andref796/AICE/AICE/bloques.jpg

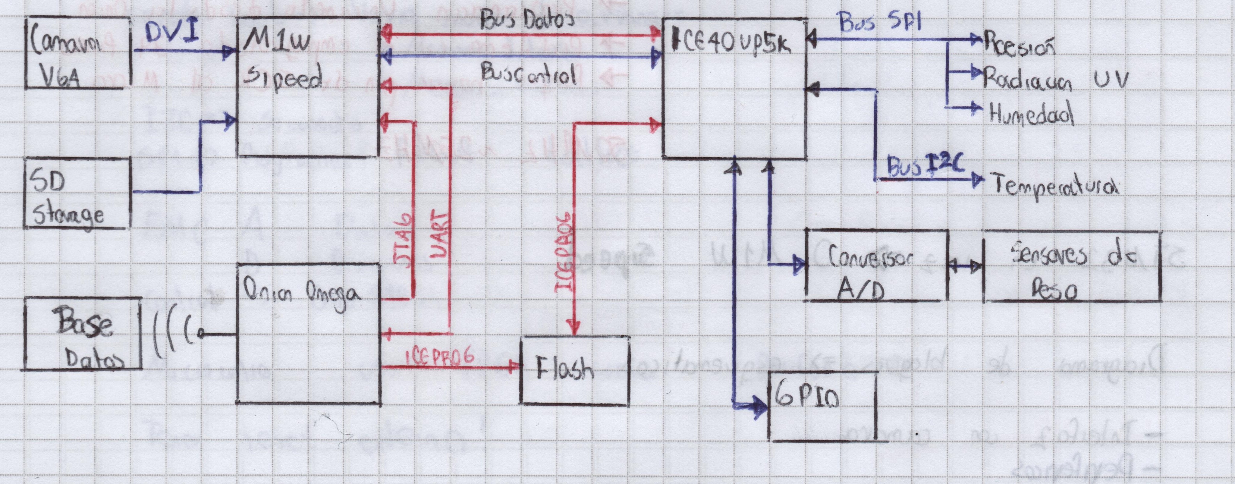
AICE/bloques.jpg
