andref796/AICE/AICE/AICE.xlsx

Customer Reference | Package | Quantity | Reference Designator | Digi-Key Part Number
C15,C14,C5 | C_0603_1608Metric | 3 | 10u | CL10A106MQ8NNNC
C22 | CP_Radial_D5.0mm_P2.00mm | 1 | 33u | 493-5346-1-ND
C33,C61,C60,C59,C56,C55,C52,C51,C48,C47,C44,C43,C39,C37,C36,C32,C31,C30,C29,C28,C27,C24,C23,C21,C20,C19,C18,C17,C16,C13,C12,C11,C10,C8,C7,C2,C26 | C_0603_1608Metric | 37 | 0.1u | 478-06036C104JAT2ACT-ND
C38 | C_1206_3216Metric | 1 | 220u | 490-13970-1-ND
C42 | C_0603_1608Metric | 1 | 0.001u | C0603C102K9RAC7867
C58,C57,C54,C53,C50,C49,C46,C45,C41,C40,C35,C34 | C_0805_2012Metric | 12 | 33u | 445-5986-1-ND
C6,C1 | C_0603_1608Metric | 2 | 1u | 311-1447-1-ND
C9,C4,C3 | C_0603_1608Metric | 3 | 0.01u | 399-8988-1-ND
D1 | LED_0603_1608Metric | 1 | CDBU0520 | 641-1332-1-ND
D10 | LED_0603_1608Metric | 1 | YLL | 720-KYDELMS122A1787
D2, D8 | LED_0603_1608Metric | 2 | GREEN | 720-KGDELMS122A4854
D3,D6 | LED_RGB_Cree-PLCC-6_6x5mm_P2.1mm | 2 | LED_RGB | CLP6C-FKB-CK1P1G1BB7R3R3CT-ND
D4 | D_SMA | 1 | SMAZ5V1-TP | SMAZ5V1-TPMSCT-ND
D5 | SOT-23 | 1 | SP0502BAHT | F2714CT-ND
D7 | LED_0603_1608Metric | 1 | RED | 720-KODELMS122A4855
H1,H2,H3,H4 | MountingHole_2.5mm_Pad | 4 | MountingHole_Pad
J1,J2,J5,J6 | PinHeader_2x50_P2.54mm_Vertical | 1 | Conn_02x50_Odd_Even | 649-77313-118-50LF
J3 | PinHeader_1x03_P2.54mm_Vertical | 1 | Conn_01x03
J4 | USB_A_Stewart_SS-52100-001x_Horizontal | 1 | USB_A | 380-1412-ND
J7 | microSD_HC_Wuerth_693072010801 | 1 | Micro_SD_Card | 732-3820-1-ND
J8 | USB_Micro-B_Molex_47346-0001 | 1 | USB_B_Micro | WM17141TR-ND
L8,L7,L6,L5,L4,L3,L2,L1 | L_0805_2012Metric | 8 | 2A 120 ohm | MH2029-121YCT-ND
Q1 | SOT-23 | 1 | S8550 | MMSS8550-H-TPMSCT-ND
R1,R50,R49,R48,R47,R46,R6,R5 | R_0603_1608Metric | 8 | 100R | 2019-RK73H1JTTD1000FCT-ND
R92,R91,R16,R15 | R_0603_1608Metric | 4 | 2K2 | 311-2.20KCRCT-ND
R102,R103,R104,R105 | R_0603_1608Metric | 4 | 4R7 | 2019-RK73H1JTTD4R70FCT-ND
R2,R95,R96,R98,R89,R37 | R_0603_1608Metric | 6 | 51R | 2019-RK73H1JTTD51R0FCT-ND
R90,R53,R4,R3,R94,R93,R54,R36,R27,R26,R25 | R_0603_1608Metric | 12 | 10K | 311-10KGRCT-ND
U1 | QFN-48-1EP_7x7mm_P0.5mm_EP5.6x5.6mm | 1 | ICE40UP5K-SG48ITR | 220-2212-1-ND
U11 | Molex_502231-2400_1x24-1SH_P0.5mm_Vertical | 1 | DVP_PORT | WM9863CT-ND
U13,U15 | SOT-223 | 2 | ZLDO1117G33TA | ZLDO1117G33DICT-ND
U14 | SOT-23 | 1 | XC6206P122MR | 865-XC6206P122MR-G
U16 | SOT-223 | 1 | ZLDO1117G18TA | ZLDO1117G18DICT-ND
U17 | SOT-23 | 1 | XC6206P282MR | 865-XC6206P282MR-G
U18 | SOT-23 | 1 | XC6206P152MR | 865-XC6206P152MR-G
U2 | ASFLMB | 1 | ASFLMB-24.00MHZ-LC-T | 535-11768-1-ND
U3,U7,U12 | SMS_BUTTON | 3 | SMS | 612-LL3303F065QG
U4 | SOIC-8_5.23x5.23mm_P1.27mm | 1 | W25Q | W25Q128JVSIQCT-ND
U5 | SOP-16_4.4x10.4mm_P1.27mm | 1 | HX711
U6 | Onion_Omega2+ | 1 | Omega2+
U8 | SRF2012 | 1 | SRF2012 | SRF2012-900YACT-ND
U9 | QFN-72_25.4x25.4_Pitch1.27mm | 1 | M1&M1W | 1597-1715-ND
