andref796/AICE/AICE/Presupuesto.xlsx

 |  |  |  |  |  | Connector Header Through Hole 50 position 0.100" (2.54mm)
Componente | Referencia | Empaquetado | Precio | Cantidad | Total | Link
Regulador 2,8 V | XC6206P282MR-G | SOT-23-3 | 0.67 | 1 | 0.67 | https://co.mouser.com/ProductDetail/Torex-Semiconductor/XC6206P282MR-G
Regulador 1,5 V | XC6206P152MR-G | SOT-23-3 | 0.67 | 1 | 0.67 | https://co.mouser.com/ProductDetail/Torex-Semiconductor/XC6206P152MR-G
Regulador 3,3 V | ZLDO1117G33TA | SOT-223-3 | 0.47 | 2 | 0.94 | https://co.mouser.com/ProductDetail/Diodes-Incorporated/ZLDO1117G33TA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
Micro USB B Connector | 0473460001 Molex | N/A | 0.5 | 1 | 0.5 | https://www.digikey.com/product-detail/es/molex/0473460001/WM17141TR-ND/1782470
Micro SD Card | 693072010801 | N/A | 3.2 | 1 | 3.2 | https://www.digikey.com/product-detail/es/w%C3%BCrth-elektronik/693072010801/732-3820-2-ND/3124584
Flash | W25Q128JVSIQ TR | SOIC-8 | 1.54 | 1 | 1.54 | https://www.digikey.com/product-detail/en/winbond-electronics/W25Q128JVSIQ-TR/W25Q128JVSIQCT-ND/7087212
Connector Header Through Hole 50 position 0.100" (2.54mm) | N/A | N/A | 2.15 | 1 | 2.15 | https://co.mouser.com/ProductDetail/Amphenol-FCI/77313-118-50LF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
RBG_LED | CREE_PLCC6 | N/A | 0.57 | 2 | 1.14 | https://www.digikey.com/product-detail/es/cree-inc/CLP6C-FKB-CK1P1G1BB7R3R3/CLP6C-FKB-CK1P1G1BB7R3R3CT-ND/6138635
R 2,2k | RC0805FR-072K2L | 805 | 0.1 | 8 | 0.8 | https://www.digikey.com/product-detail/es/yageo/RC0805FR-072K2L/311-2-20KCRCT-ND/730623
R 10 k | RC0603JR-0710KL | 603 | 0.1 | 12 | 1.2 | https://www.digikey.com/product-detail/es/yageo/RC0603JR-0710KL/311-10KGRCT-ND/729647
R 100 |  | 603 | 0.57 |  |  | https://co.mouser.com/ProductDetail/Susumu/RGT1608P-101-B-T5
C 0,1 u FILM | ECP-U1C104MA5 | 805 | 0.66 | 37 |  | https://www.digikey.com/product-detail/en/panasonic-electronic-components/ECP-U1C104MA5/PCF1126CT-ND/285453
C 0,01 u CERAMIC | C0603C103KARACAUTO | 603 | 0.12 | 3 |  | https://co.mouser.com/ProductDetail/TDK/CGA1A2X7R1A103K030BA
C 33 u CERAMIC |  | 805 | 0.87 | 13 |  | https://co.mouser.com/ProductDetail/TDK/C2012X5R0J336M125AC?qs=sGAEpiMZZMs0AnBnWHyRQFzBYxg9rzNcNpoiI6kZLEA%3D
C 220 u Ceramic |  | 1206 | 1.35 | 2 |  | https://co.mouser.com/ProductDetail/Murata-Electronics/GRM31CC80G227ME11K
C 1 u CERAMIC |  | 805 | 0.21 | 2 |  | https://co.mouser.com/ProductDetail/Taiyo-Yuden/UMF212B7105MGHT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
C 10 u CERAMIC |  | 805 | 0.22 | 3 |  | https://co.mouser.com/ProductDetail/Taiyo-Yuden/TMK212BBJ106MGHT
C 1 n CERAMIC |  | 603 | 0.28 | 1 |  | https://co.mouser.com/ProductDetail/TDK/C1608C0G2A102J080AE
LED BLUE |  | 603 | 0.49 |  |  | https://co.mouser.com/ProductDetail/OSRAM-Opto-Semiconductors/KB-DELPS212-QHRI-24-Z555-10-S
LED GREEN |  | 603 | 0.49 |  |  | https://co.mouser.com/ProductDetail/OSRAM-Opto-Semiconductors/KG-DELMS122-PHQI-24-E6L6
LED YELLOW |  | 603 | 0.39 |  |  | https://co.mouser.com/ProductDetail/OSRAM-Opto-Semiconductors/KY-DELLS122-KGLH-26
LED RED |  | 603 | 0.41 |  |  | https://co.mouser.com/ProductDetail/OSRAM-Opto-Semiconductors/KR-DELPS122-UHVI-26-H3Q4
CDBU0520 |  | 603 | 0.45 | 1 |  | https://co.mouser.com/ProductDetail/Comchip-Technology/CDBU0520
ASFLMB-24.000MHZ-LC-T |  |  | 1.51 |  |  | https://co.mouser.com/ProductDetail/ABRACON/ASFLMB-24000MHZ-LC-T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
FPC 2-84952-4 |  | N/A | 1.7 | 1 |  | https://www.digikey.com/product-detail/en/te-connectivity-amp-connectors/2-84952-4/A100254CT-ND/2180595
Button SMS |  |  | 0.6 | 4 |  | https://co.mouser.com/ProductDetail/E-Switch/LL3303F065QG?qs=sGAEpiMZZMvxtGF7dlGNpqqmTFthXBmf4pe9dF4lIR4%3D
SP0502BAHTG |  | SOT-23 | 0.66 | 1 |  | https://co.mouser.com/ProductDetail/Littelfuse/SP0502BAHTG
SRF2012-900YA |  | N/A | 0.41 | 1 |  | https://www.digikey.com/product-detail/es/bourns-inc/SRF2012-900YA/SRF2012-900YADKR-ND/2681279
S8550 |  | SOT-23 | 0.19 | 1 |  | https://co.mouser.com/ProductDetail/Micro-Commercial-Components-MCC/MMSS8550-H-TP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
FERRITA |  | 805 | 0.1 | 5 |  | https://co.mouser.com/ProductDetail/Bourns/MH2029-121Y?qs=aqFbwuCjQol7Vp3nXKKAXw%3D%3D
 |  |  |  |  |  | https://co.mouser.com/datasheet/2/348/sa5m-1143841.pdf
DVP Connector |  |  | 1.52 | 1 |  | https://www.digikey.com/product-detail/en/molex/5022442430/WM14450DKR-ND/6133348
