andref796/AICE/AICE/Omega2P v17.step

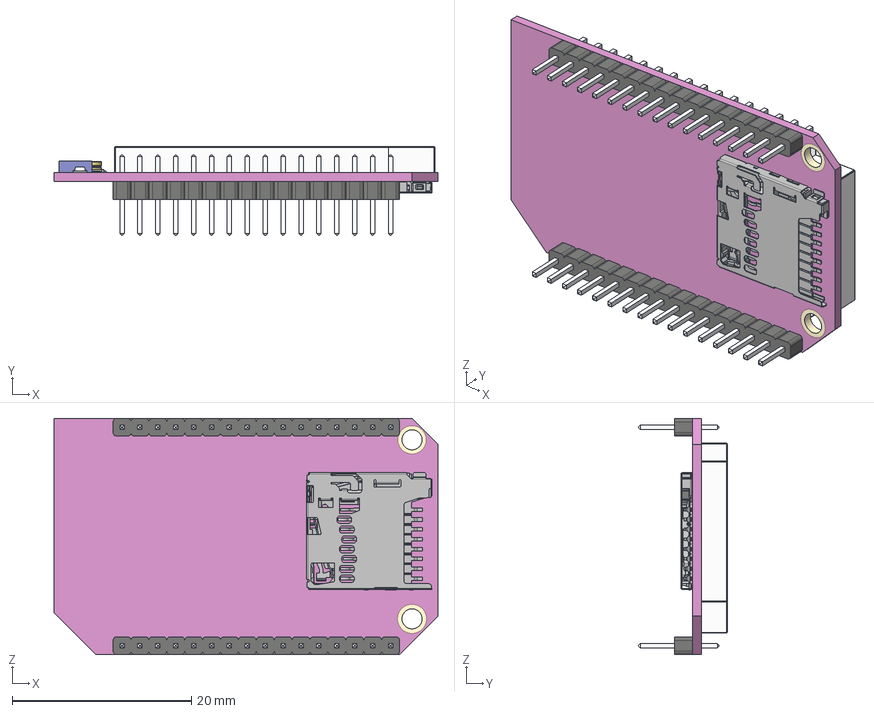
[picture p2: CAD file, 2020-06-23]
AICE/Omega2P v17.step
42.9 x 9.91 x 26.4 mm
5033981892 - MicroSD
Header SIP Male 2.00mm Pitch x 2
ufl
Chip Antenna
0603 LED
