andref796/AICE/(list of files, cad)

Other CAD files:
AICE/3D case/write/braille.dxf
AICE/3D case/write/Letters.dxf
AICE/3D case/write/knewave.dxf
AICE/3D case/write/BlackRose.dxf
AICE/3D case/write/orbitron.dxf
AICE/3D case/write/Write.scad
AICE/3D case/write/TestFont.scad
AICE/3D case/write/TestFont2.scad
AICE/3D case/write/TestSurfaceText.scad
AICE/3D case/write/TestWrite.scad
AICE/3D case/write/TestWriteCube.scad
AICE/3D case/write/TestWriteCylinder.scad
AICE/3D case/write/TestWriteSphere.scad
