andref796/AICE/Ejemplos/chip_media.pdf

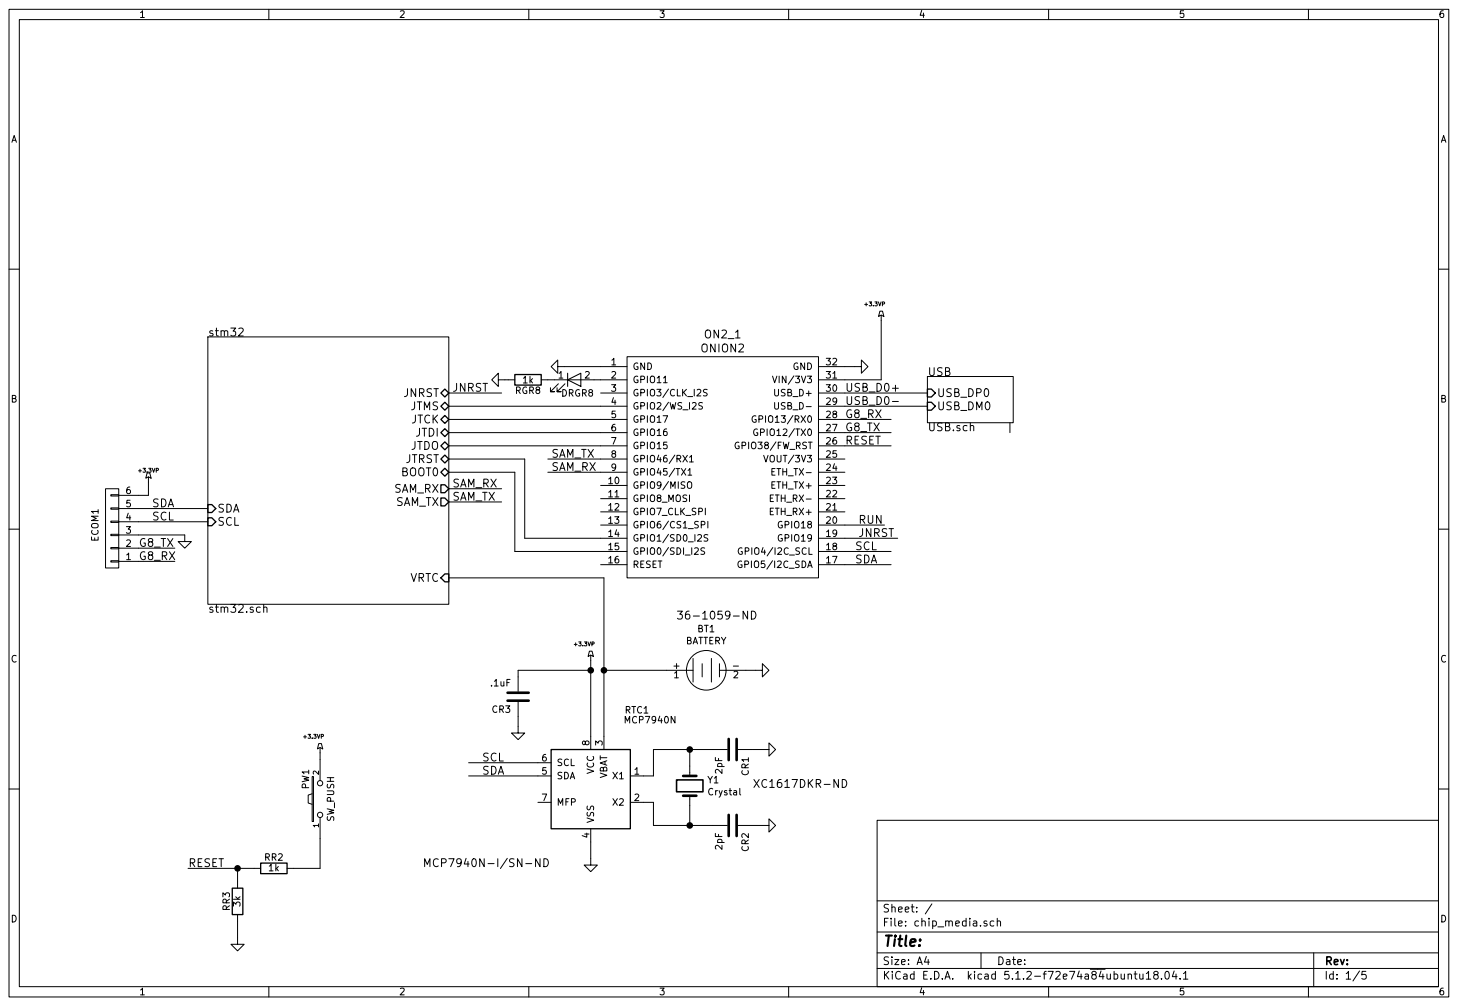
[picture p3: page 1]

4 SDA 5 SCL 6 MFP 7 VCC

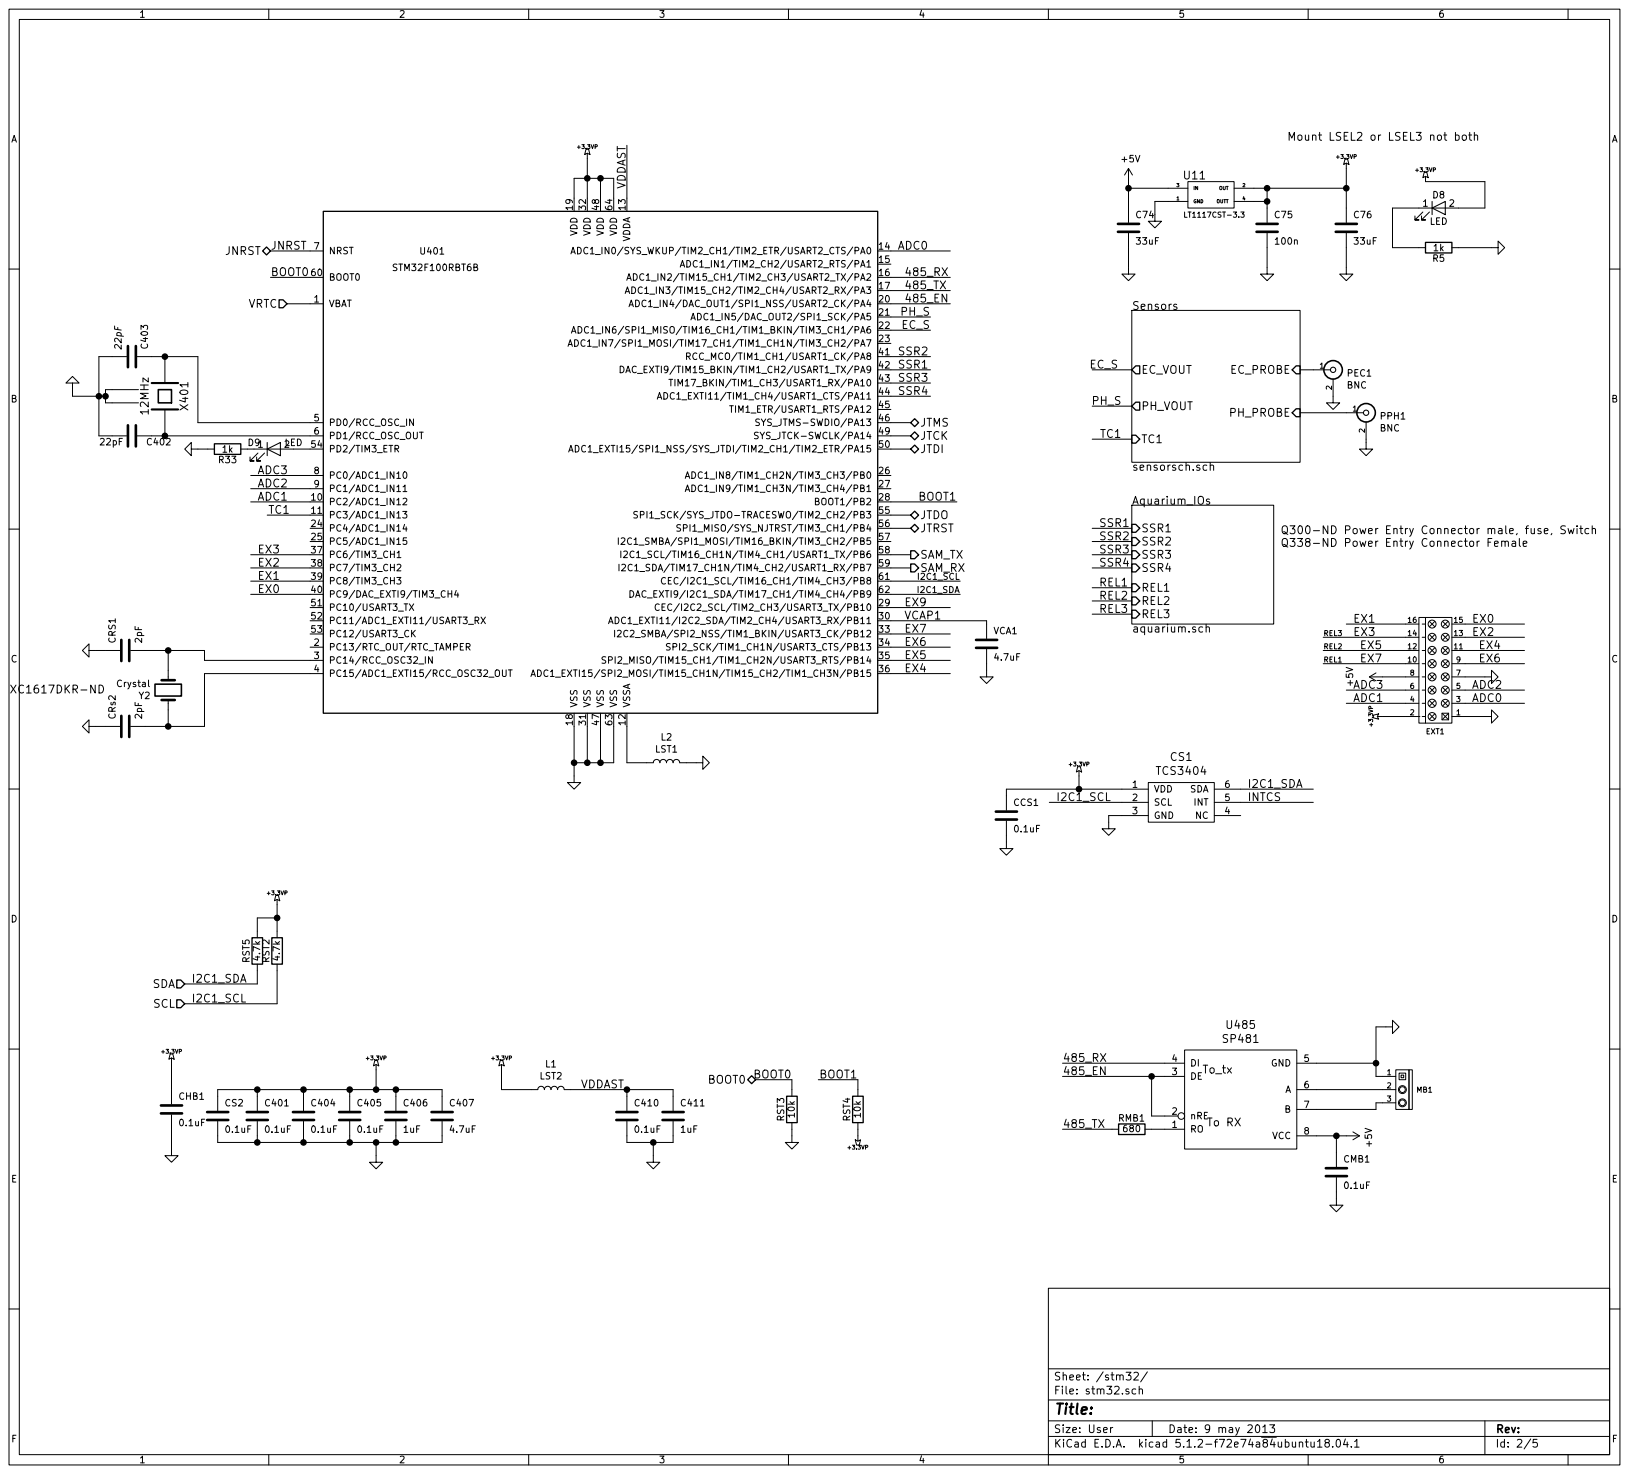
[picture p4: page 2]

Mount LSEL2 or LSEL3 not both

Q338-ND Power Entry Connector Female SSR3

Id: 2/5 Title: File: stm32.sch Sheet: /stm32/

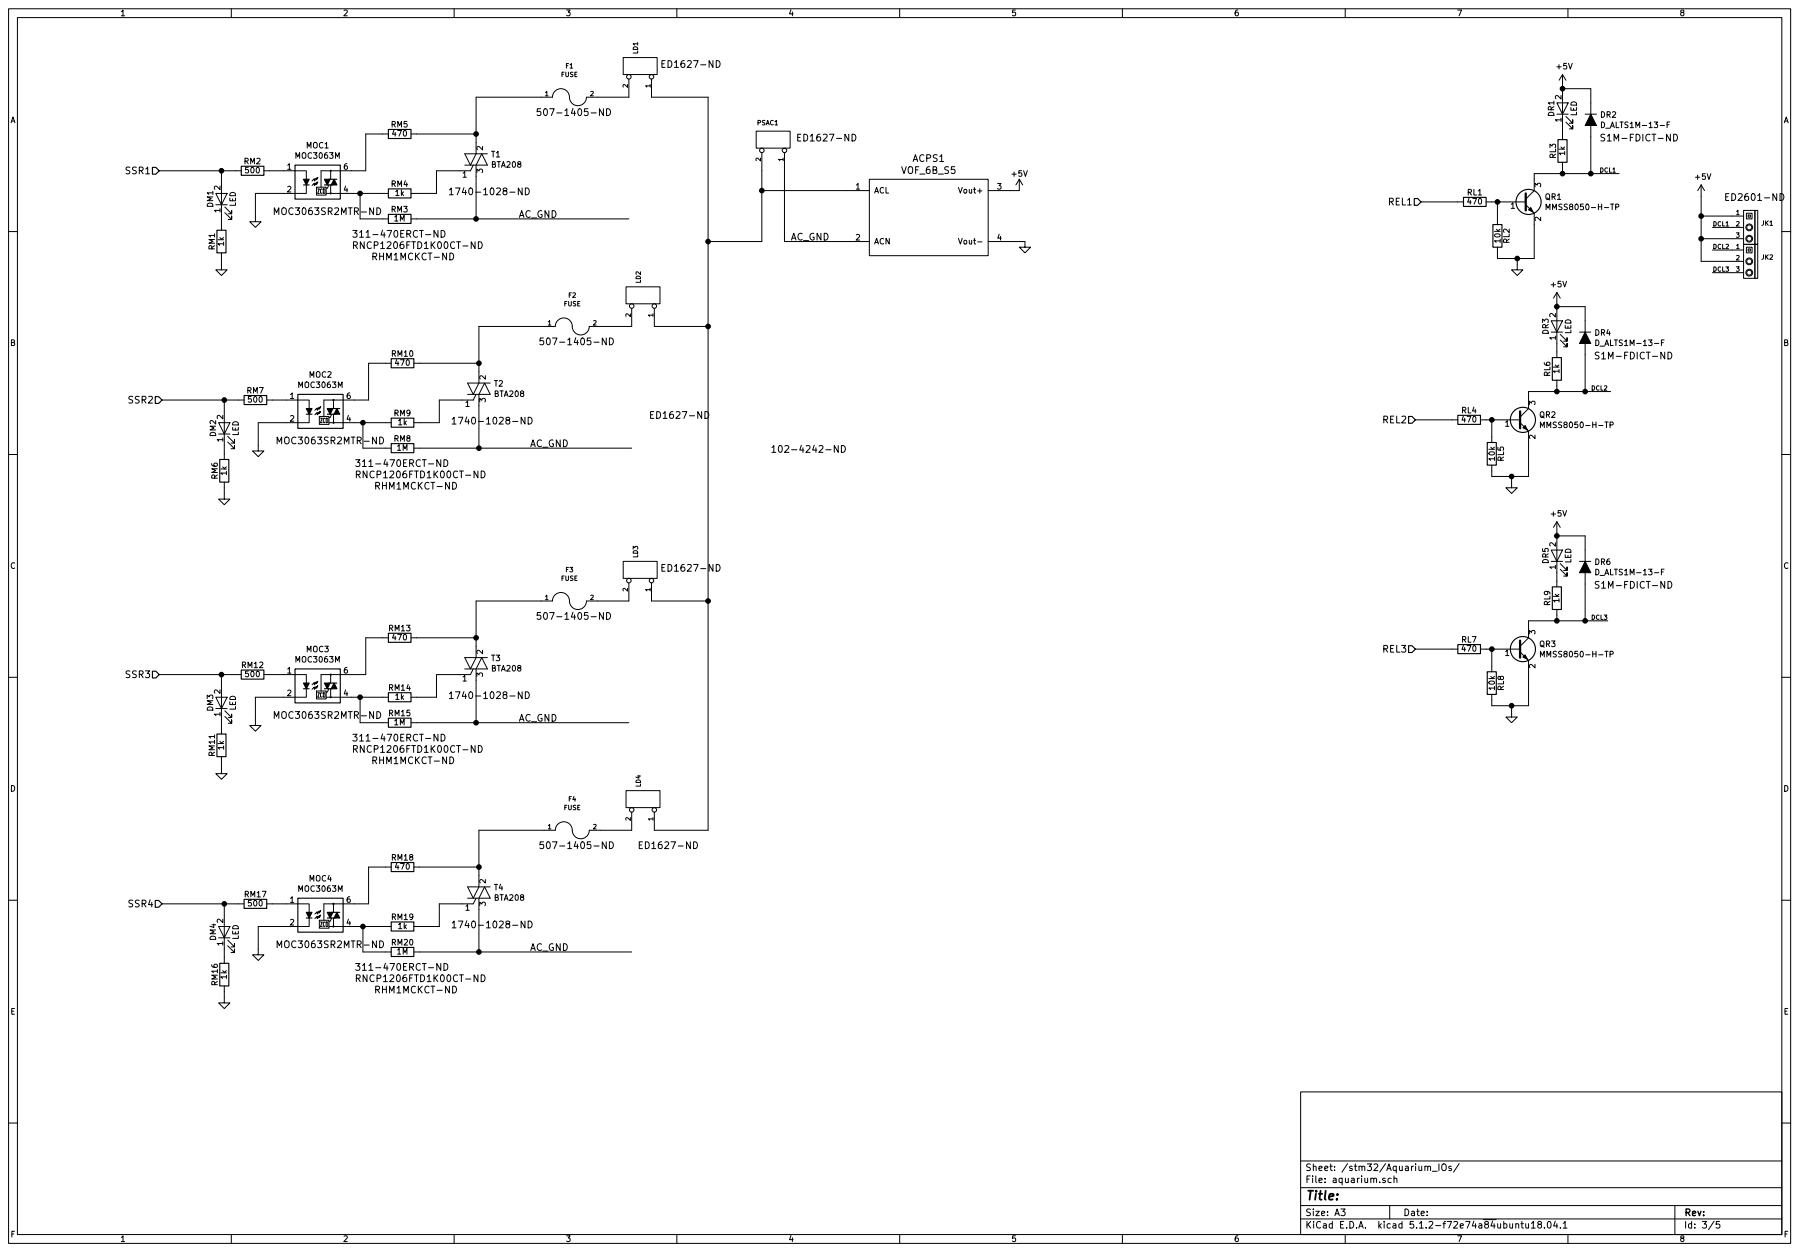
[picture p5: page 3]

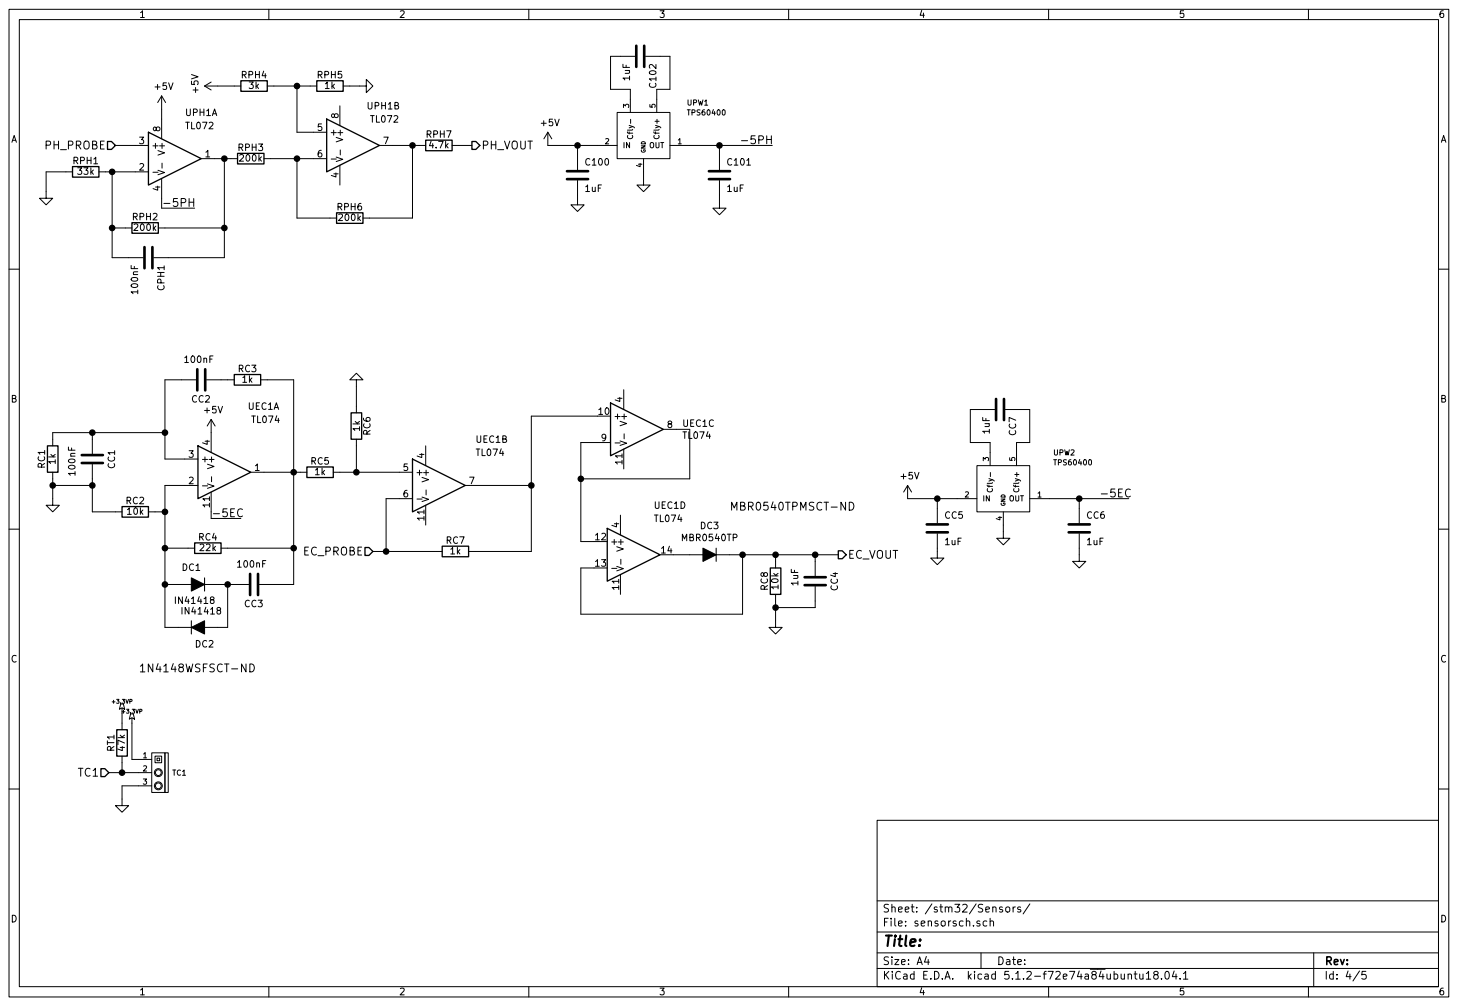
[picture p6: page 4]

Id: 4/5 Title: File: sensorsch.sch Sheet: /stm32/Sensors/ V- 4 V+

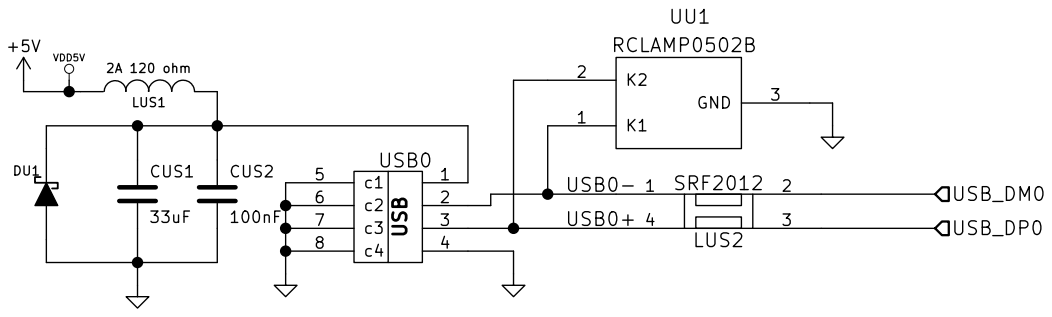
[picture p7: page 5]
