andref796/AICE/Ejemplos/i.MX283_Board.pdf

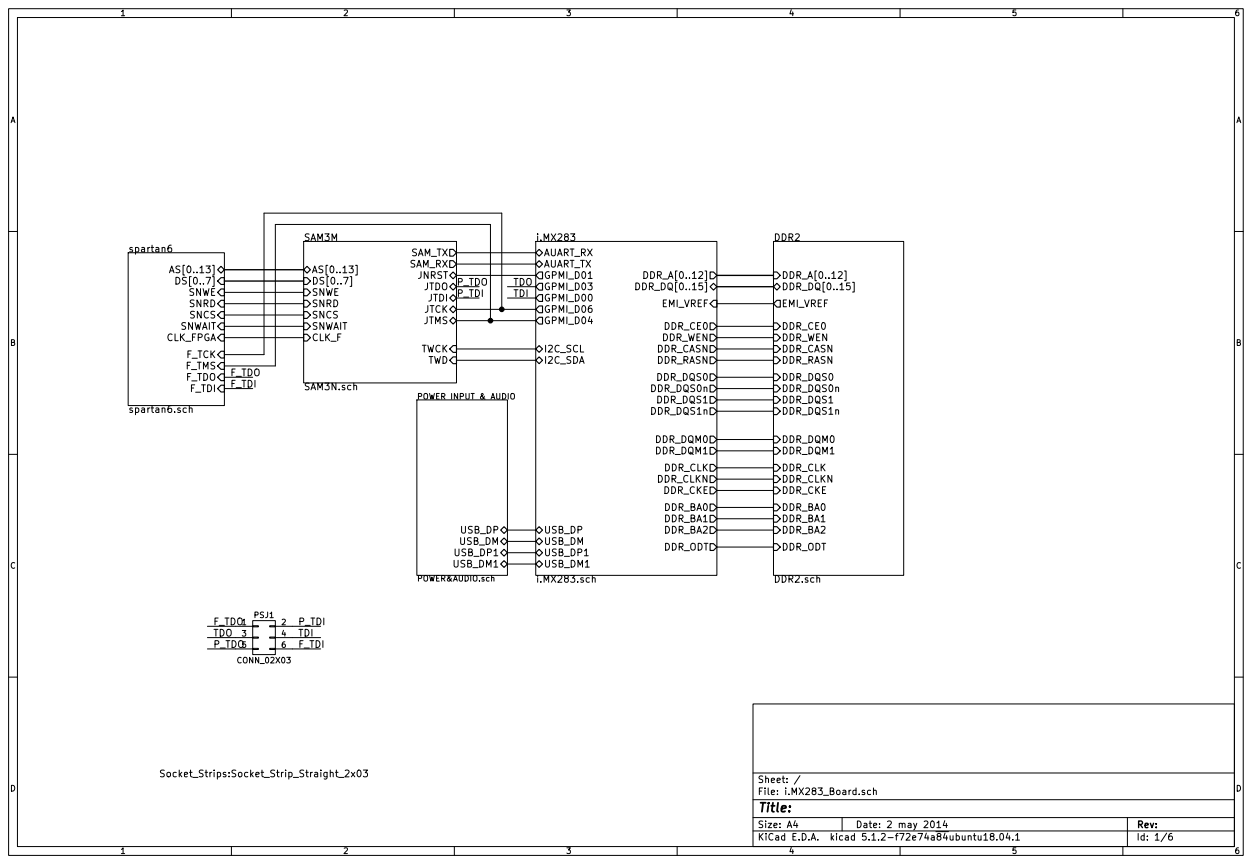
[picture p8: page 1]

SAM_TX SNRD JTCK SNCS JTMS SNWAIT TWCK TWD

P_TDO | TDO
P_TDI

F_TDI

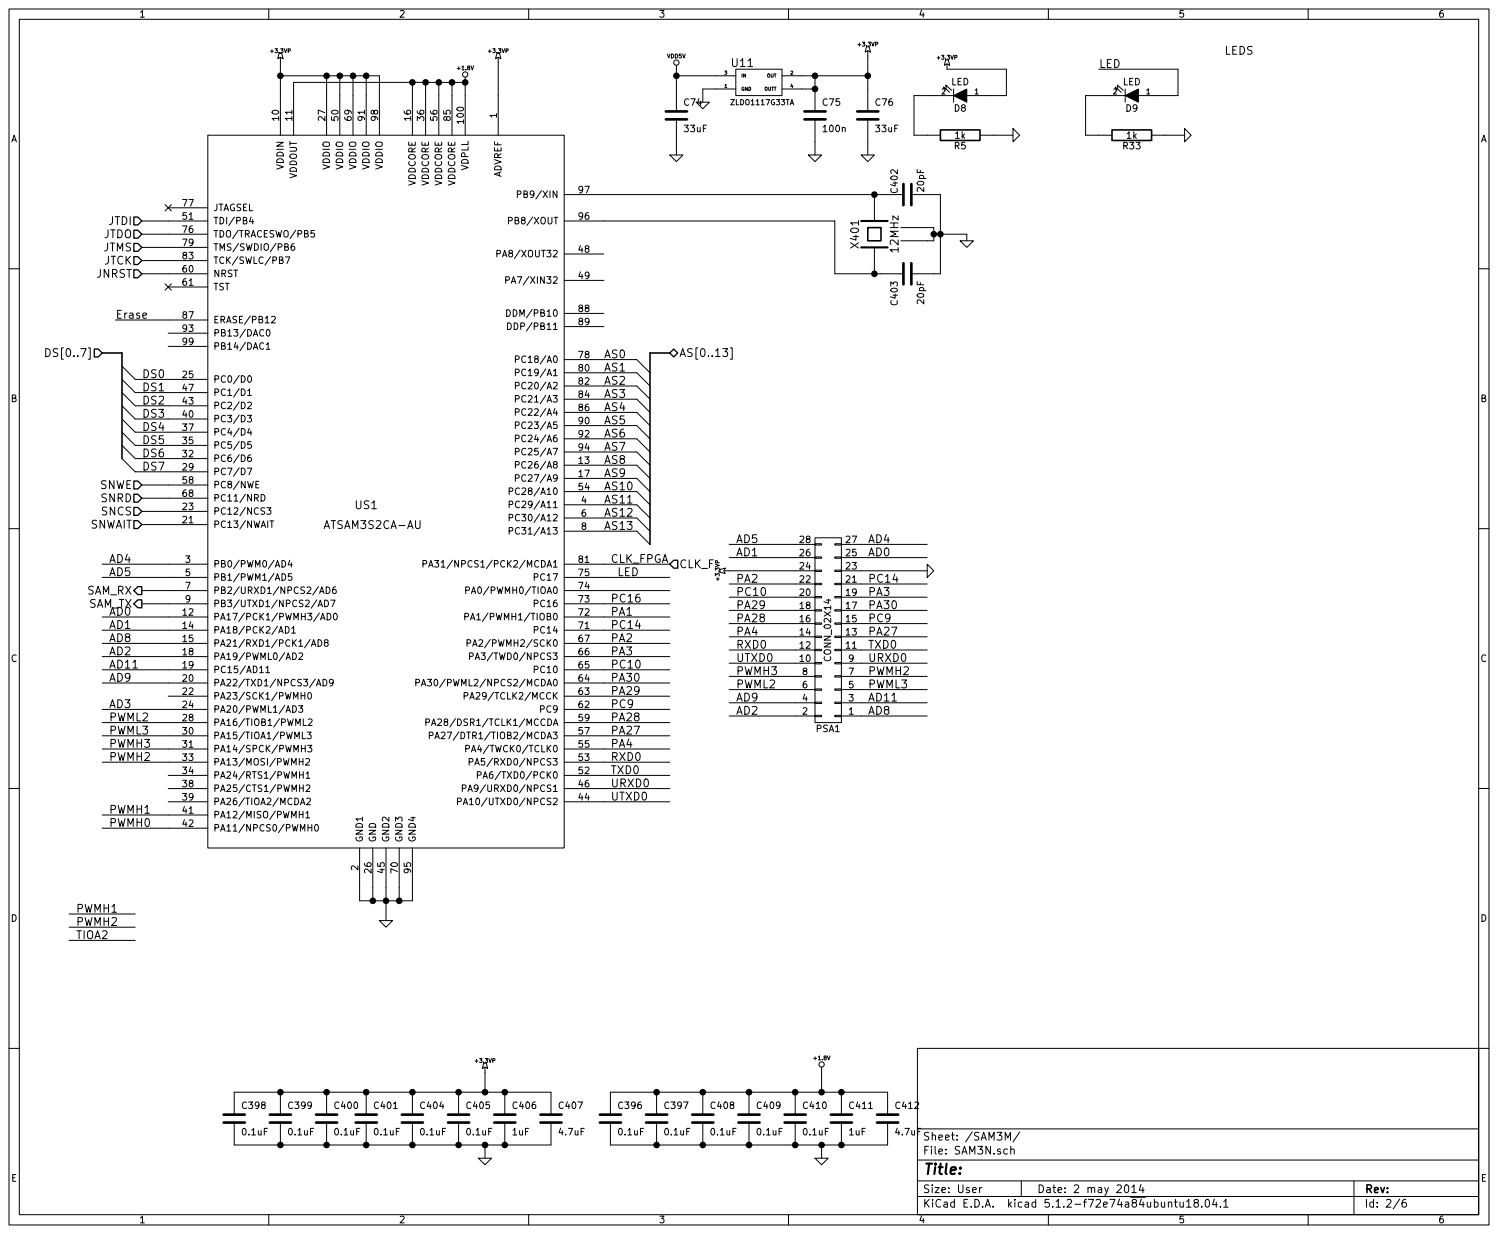
[picture p9: page 2]

2 PB0/PWM0/AD4 3 PC29/A11 4 PB1/PWM1/AD5 5 PC30/A12 6 PB2/URXD1/NPCS2/AD6 7 PC31/A13 8 PB3/UTXD1/NPCS2/AD7 9 VDDIN 10 PA22/TXD1/NPCS3/AD9 20 PA15/TIOA1/PWML3 30 PC3/D3 40 VDDIO 50 NRST 60 GND3 70 PC19/A1 80 PC23/A5 90 VDDOUT 11 PC13/NWAIT 21 PA14/SPCK/PWMH3 31 PA12/MISO/PWMH1 41

Id: 2/6 Title: File: SAM3N.sch Sheet: /SAM3M/

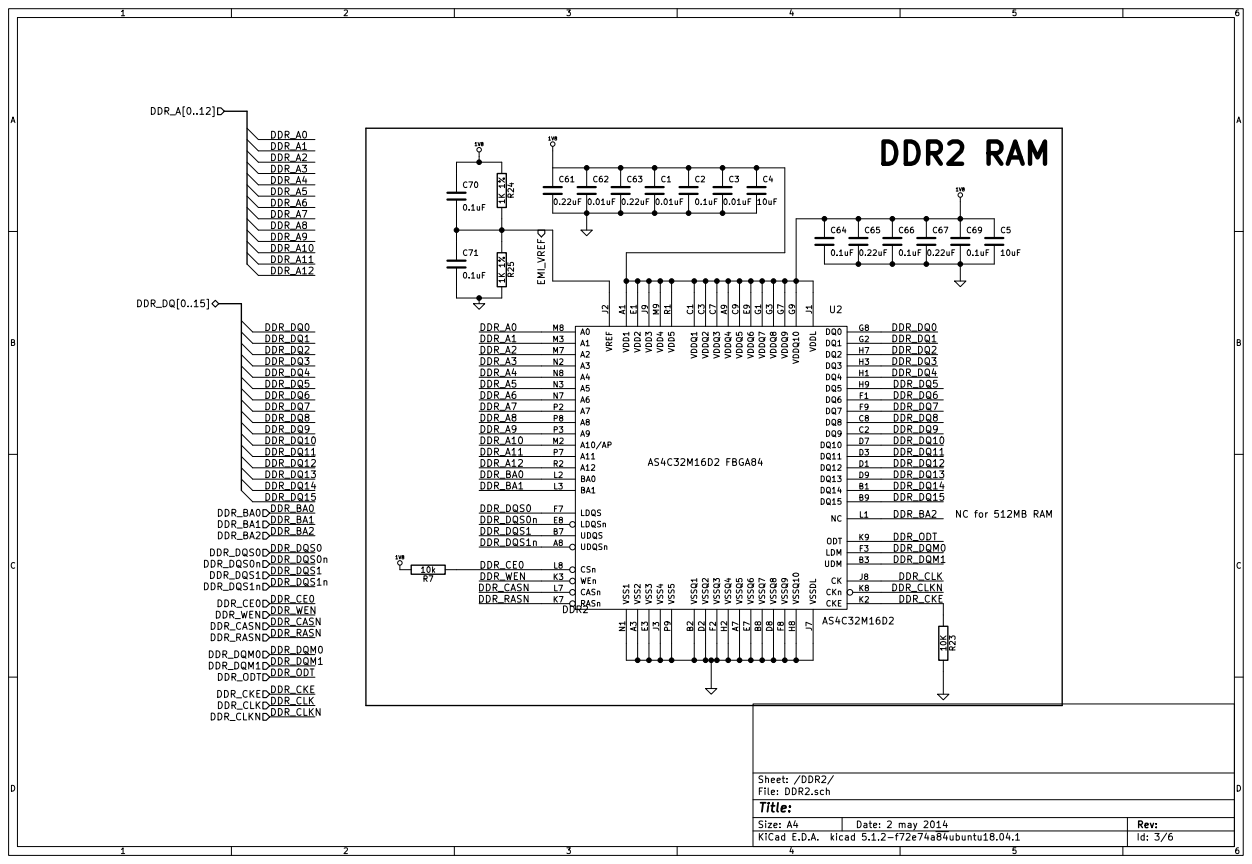
[picture p10: page 3]

Id: 3/6 Title: File: DDR2.sch Sheet: /DDR2/ R7

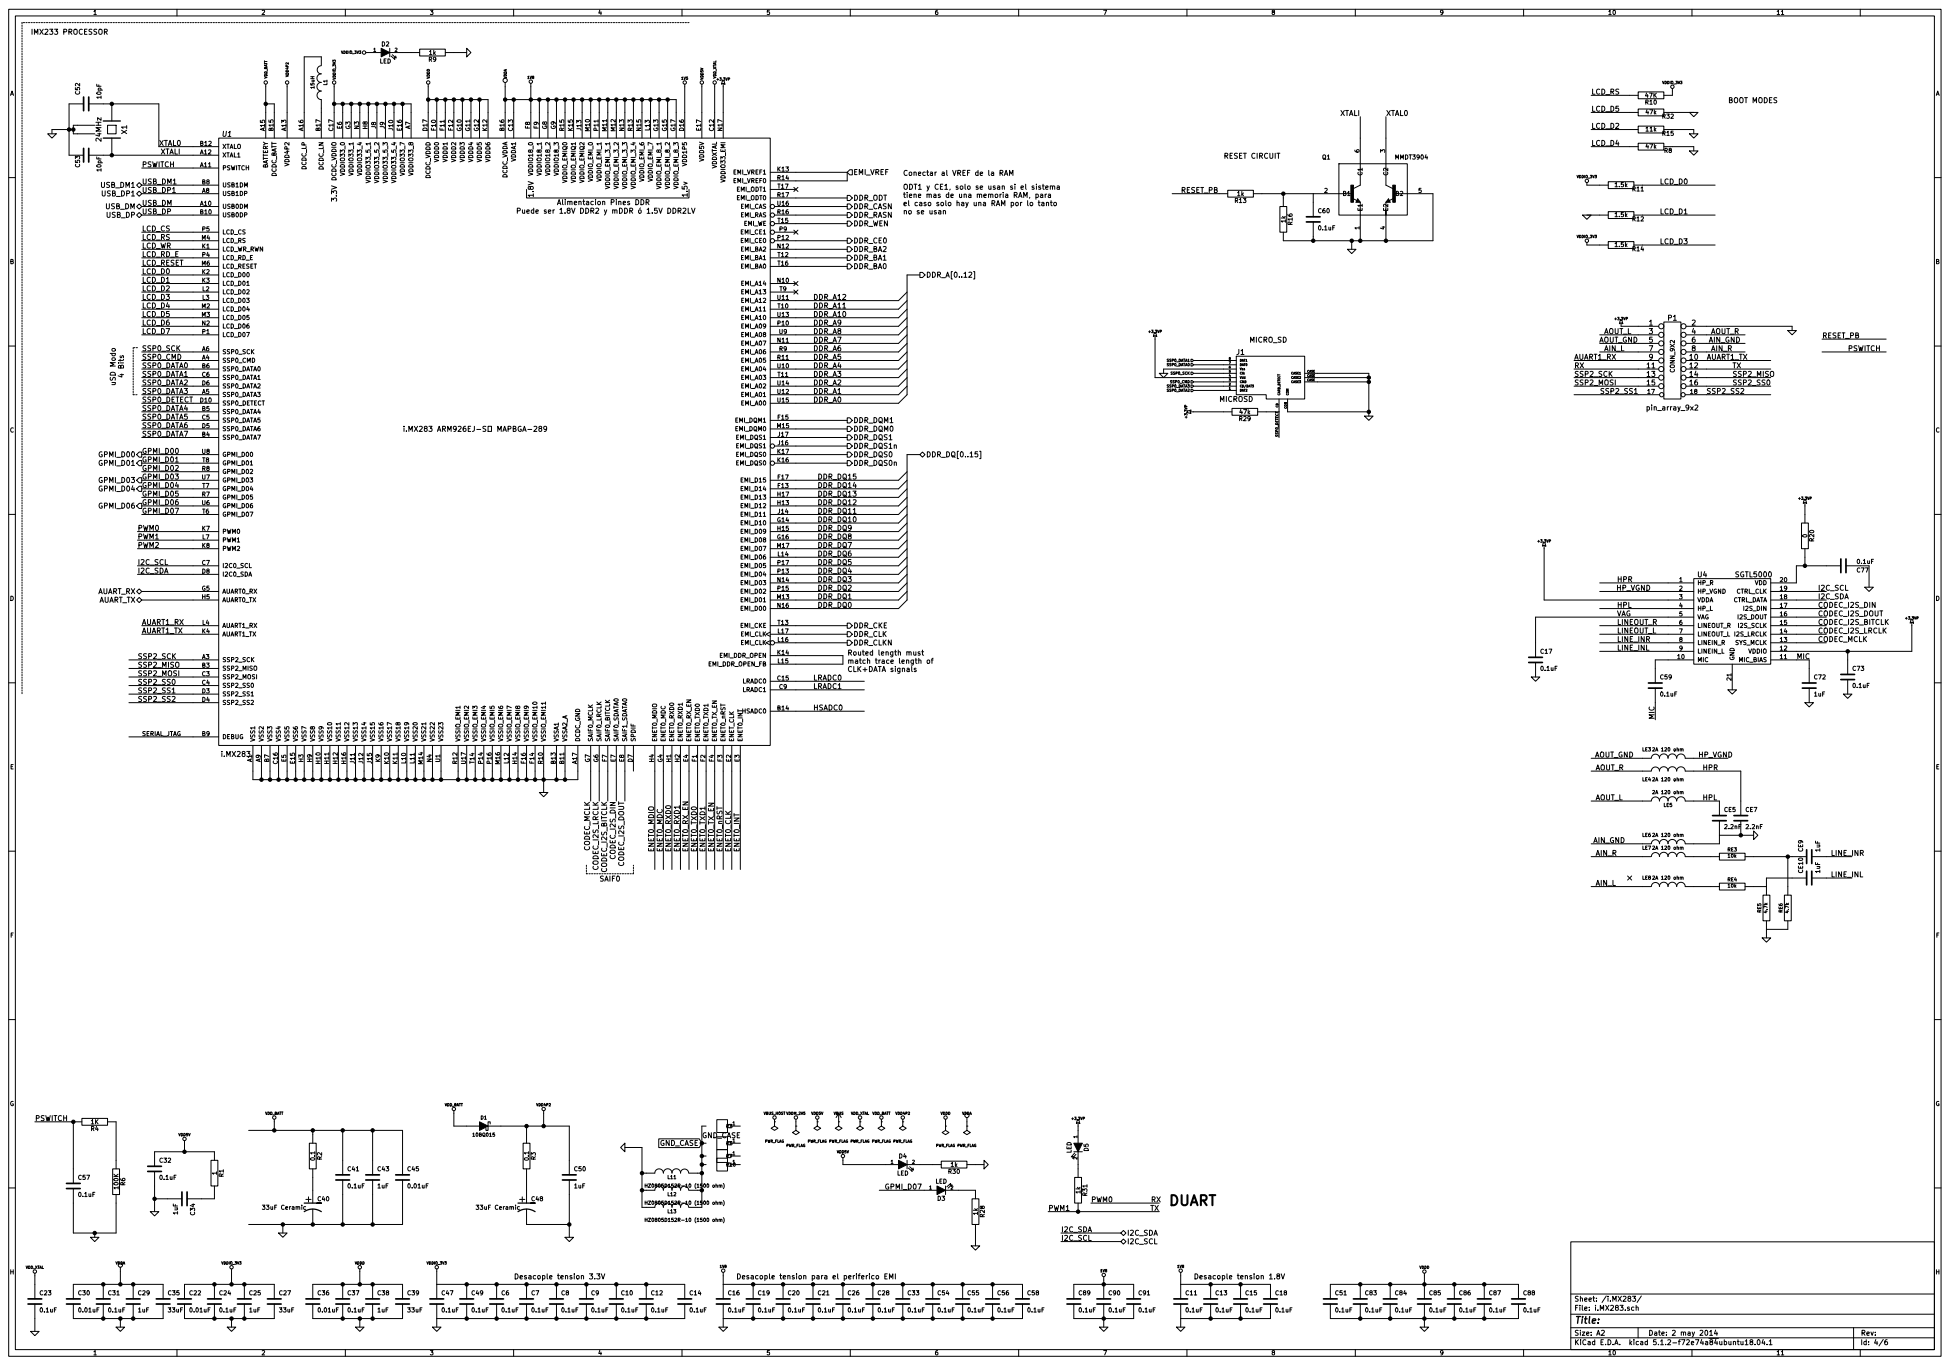
[picture p11: page 4]

el caso solo hay una RAM por lo tanto no se usan Conectar al VREF de la RAM
ODT1 y CE1, solo se usan si el sistema
tiene mas de una memoria RAM, para

0.1uF Desacople tension para el periferico EMI C26

Id: 4/6 Title: File: i.MX283.sch Sheet: /i.MX283/

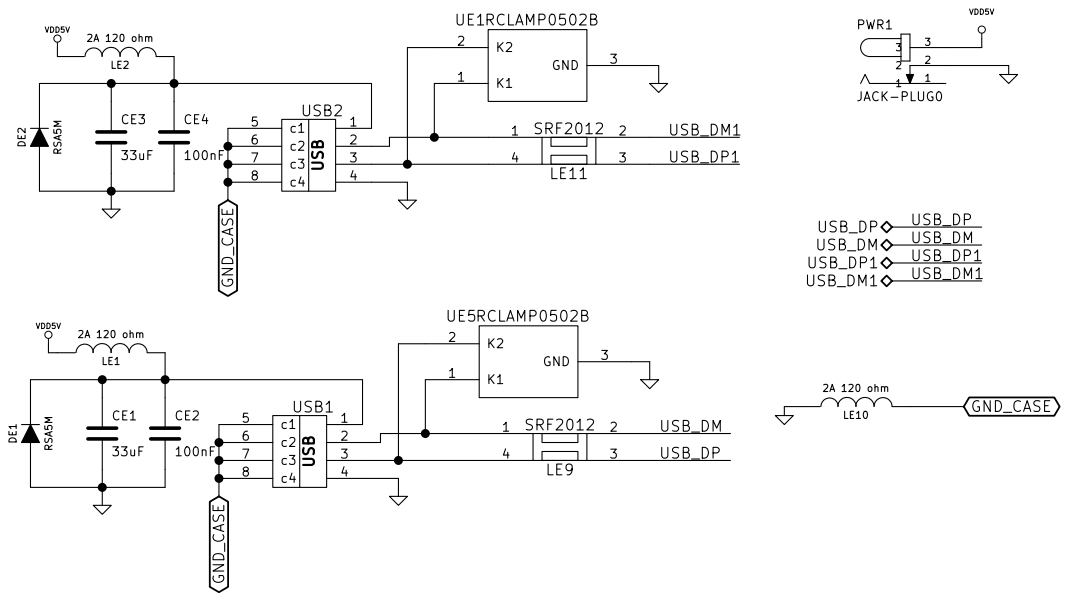
[picture p12: page 5]

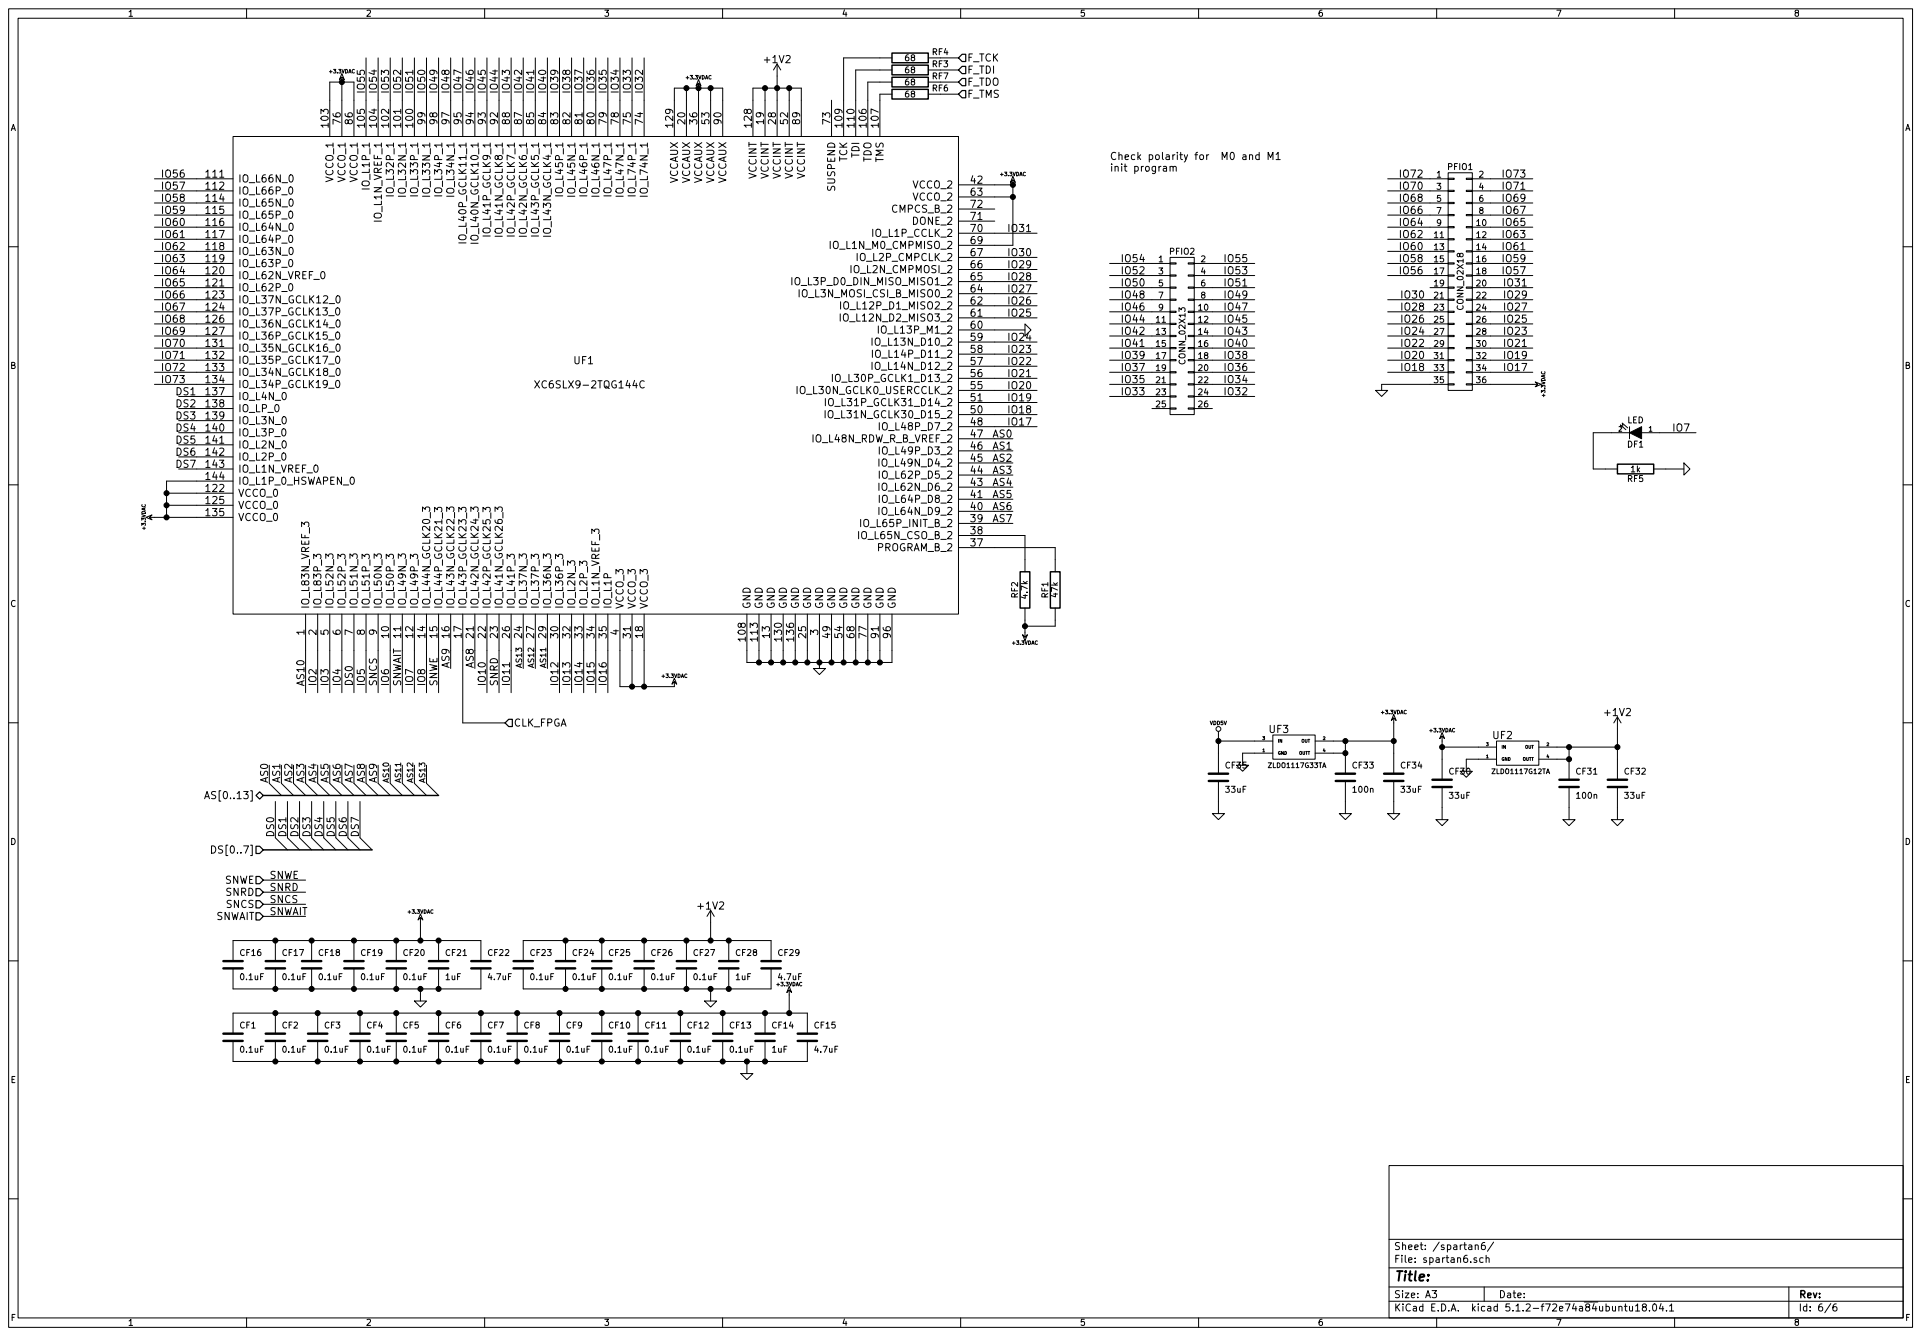
[picture p13: page 6]

Check polarity for M0 and M1
