andref796/AICE/Ejemplos/pcb_embedded_systems.pdf

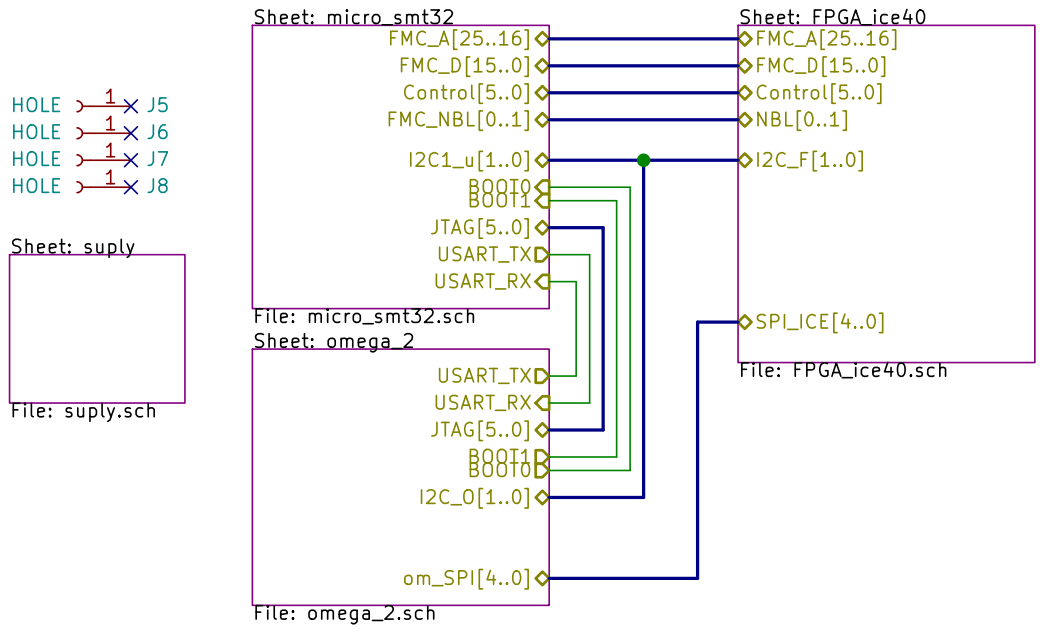
[picture p14: page 1]

Id: 1/5 Title: BLOQUES JERARQUICOS PCB

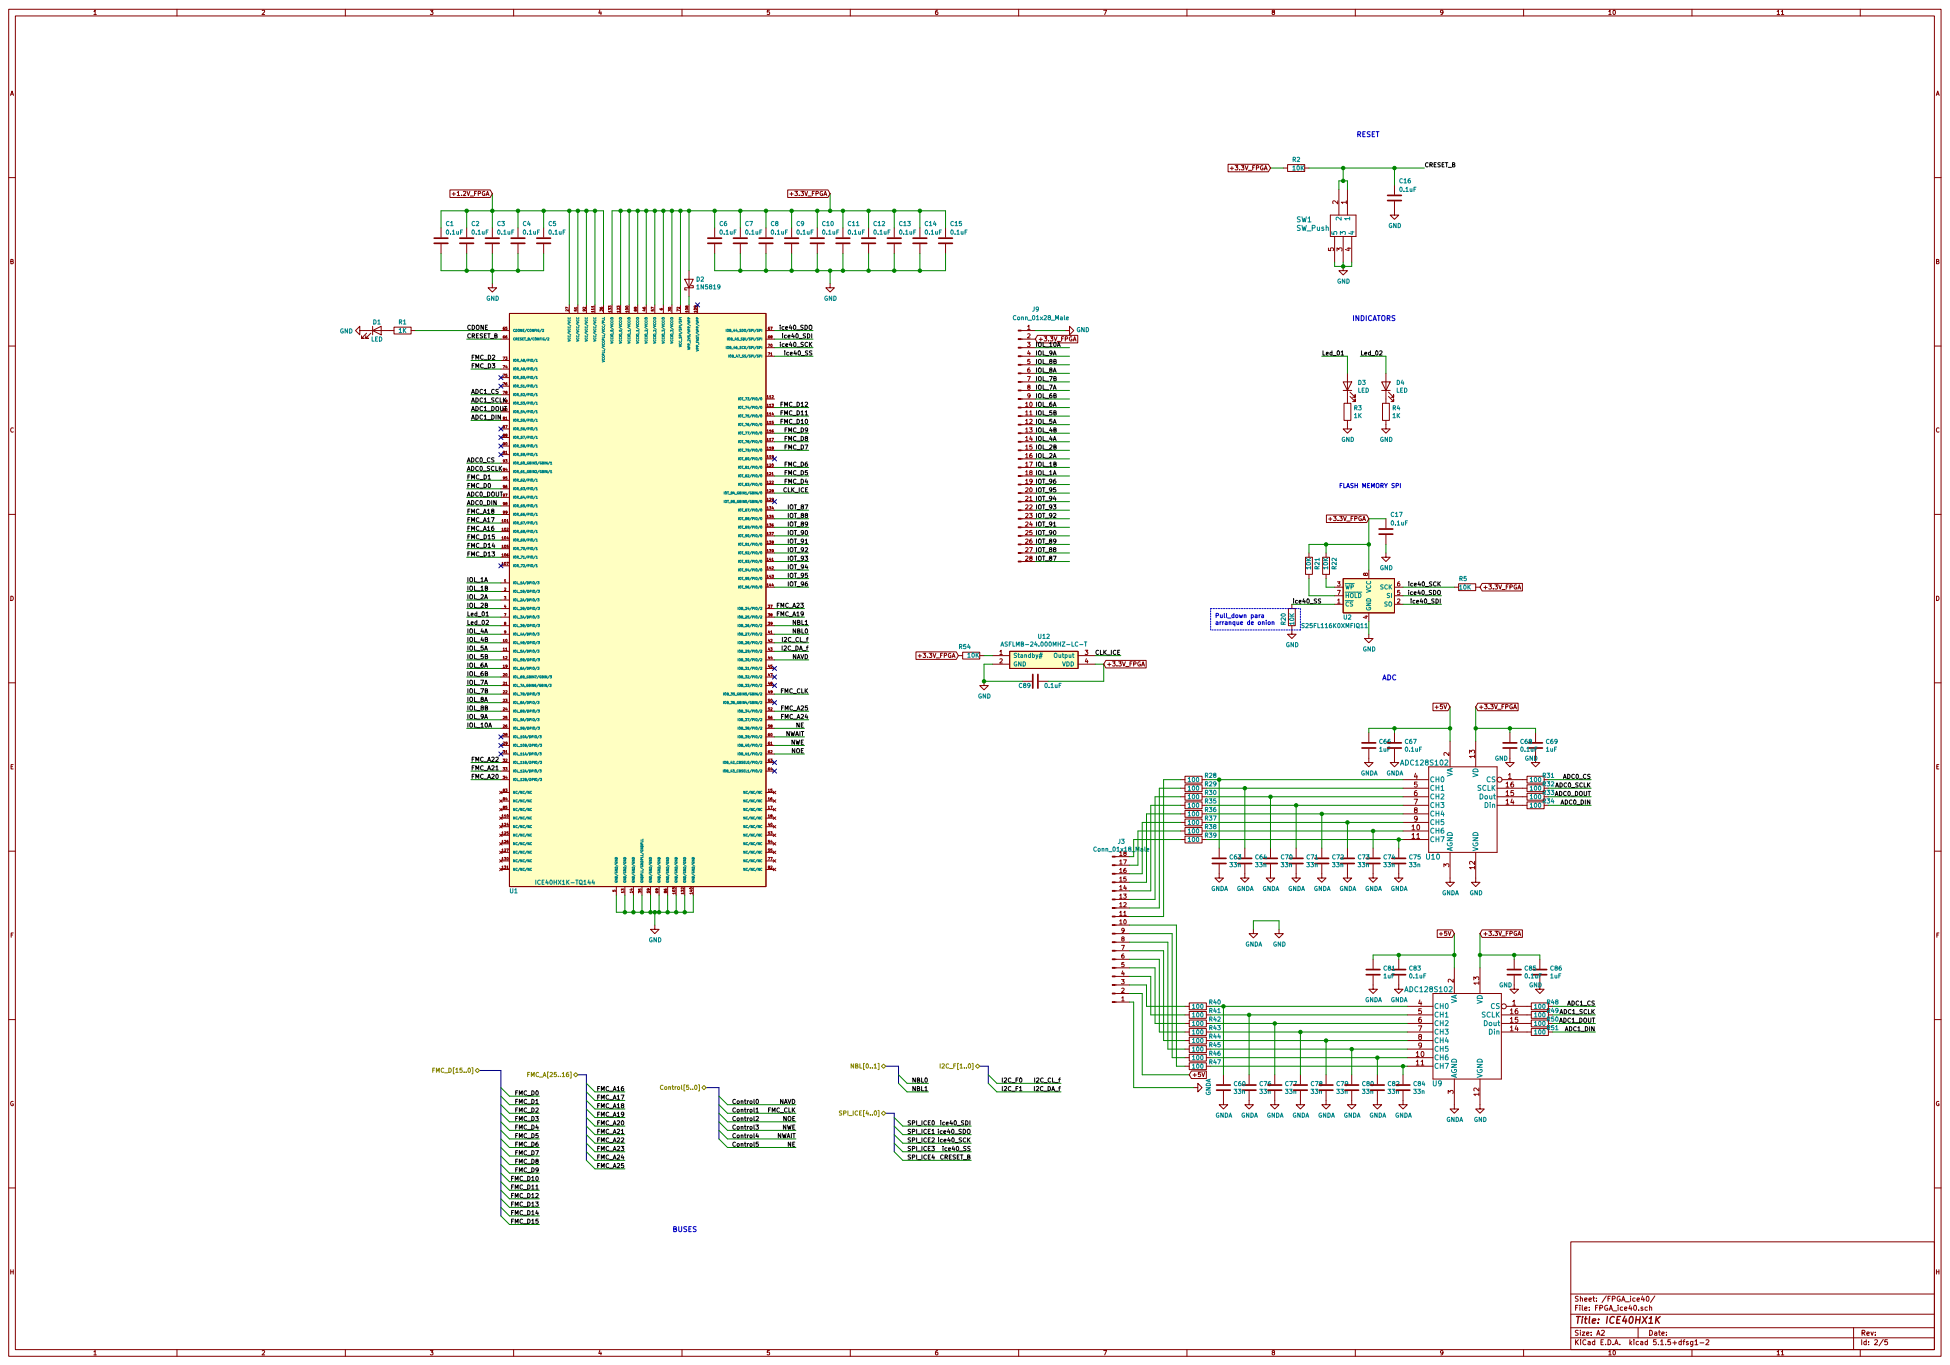
[picture p15: page 2]

CLK_ICE NE NWAIT NWE NOE

FMC_CLK
NE NWAIT NWE NOE

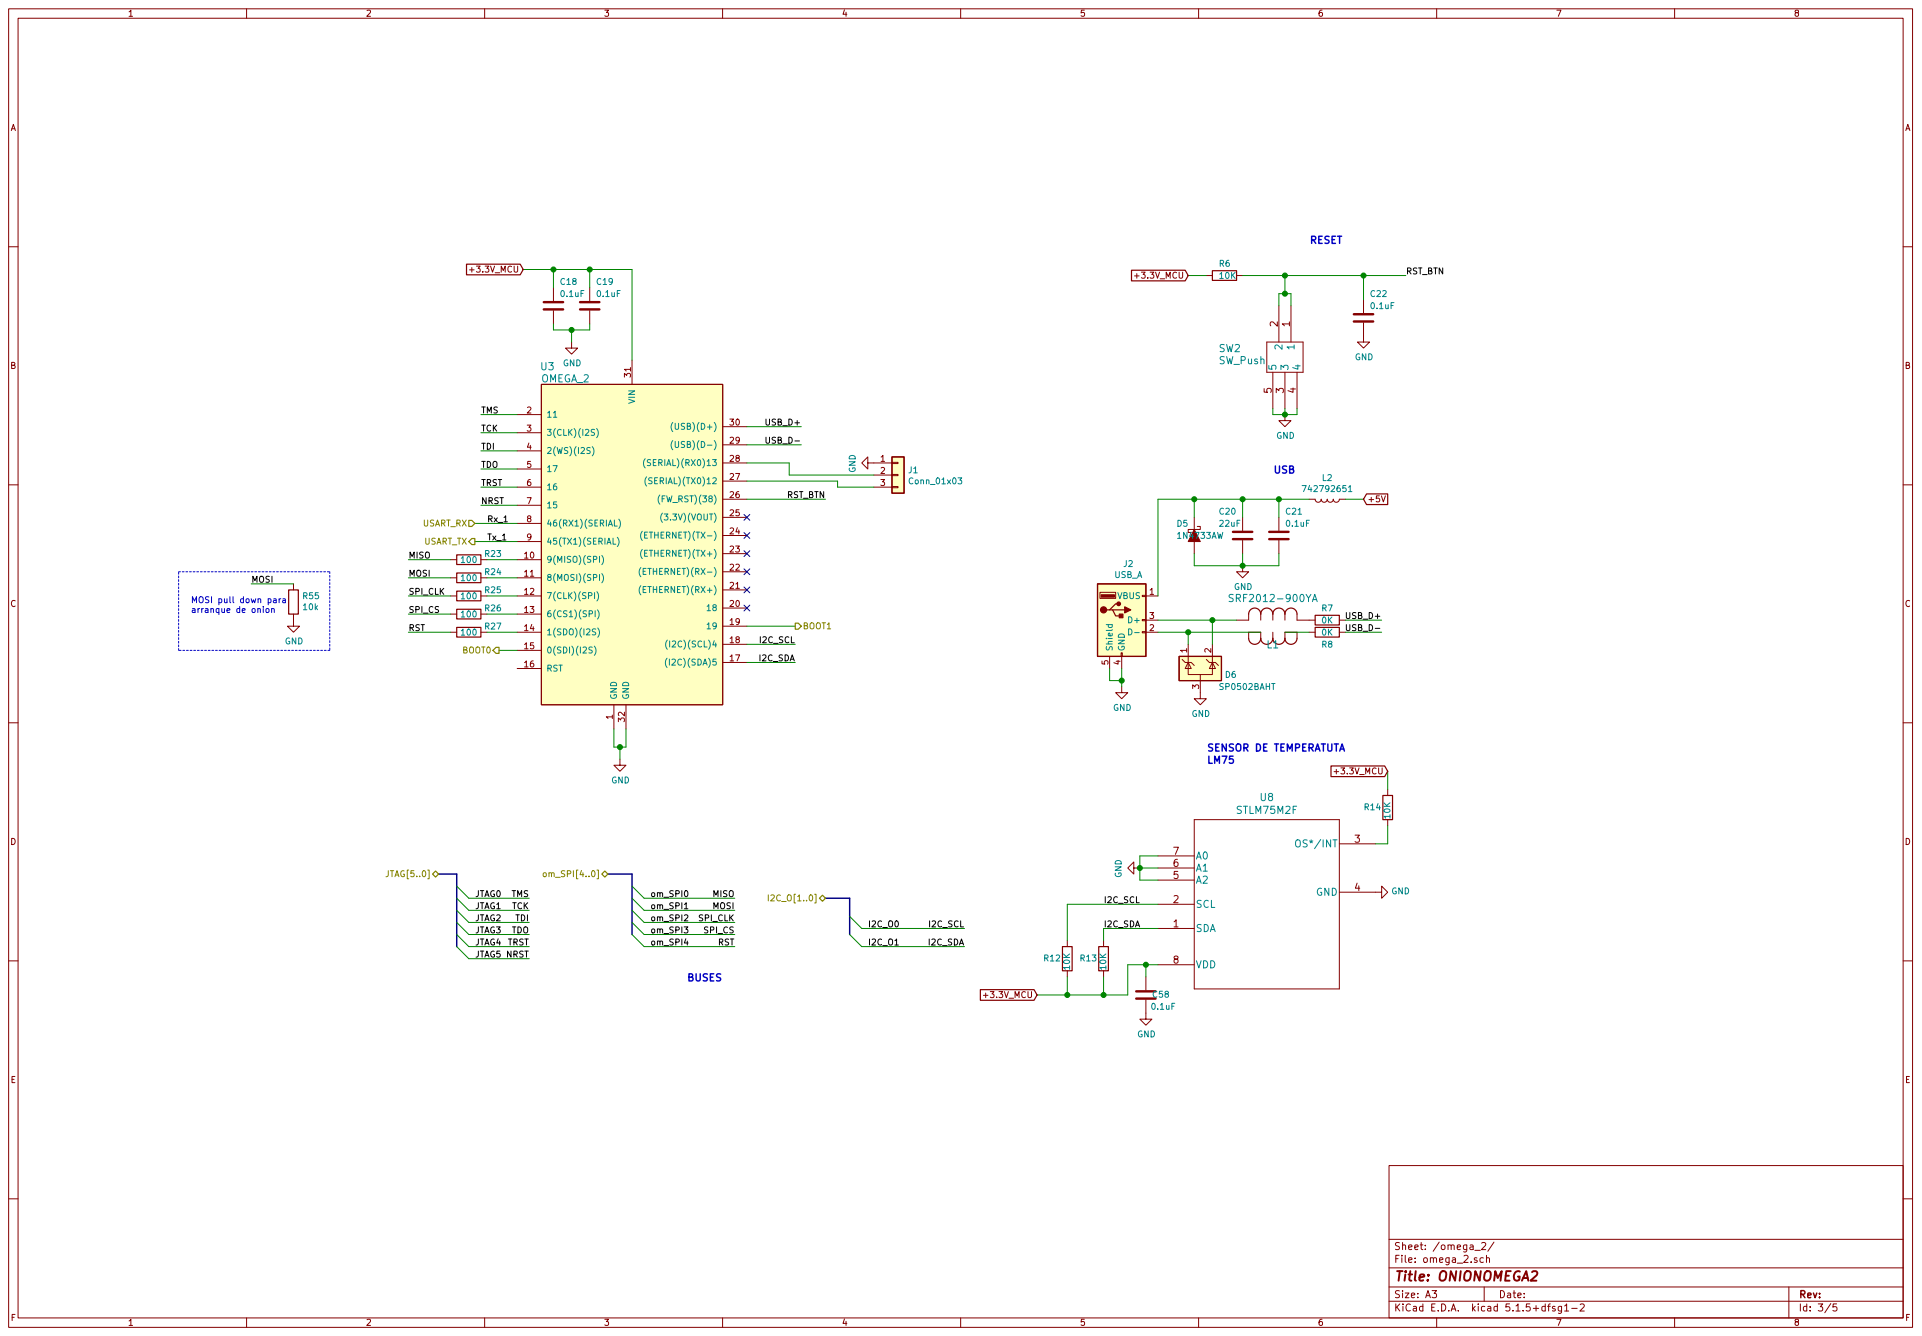
[picture p16: page 3]

LM75 MOSI pull down para

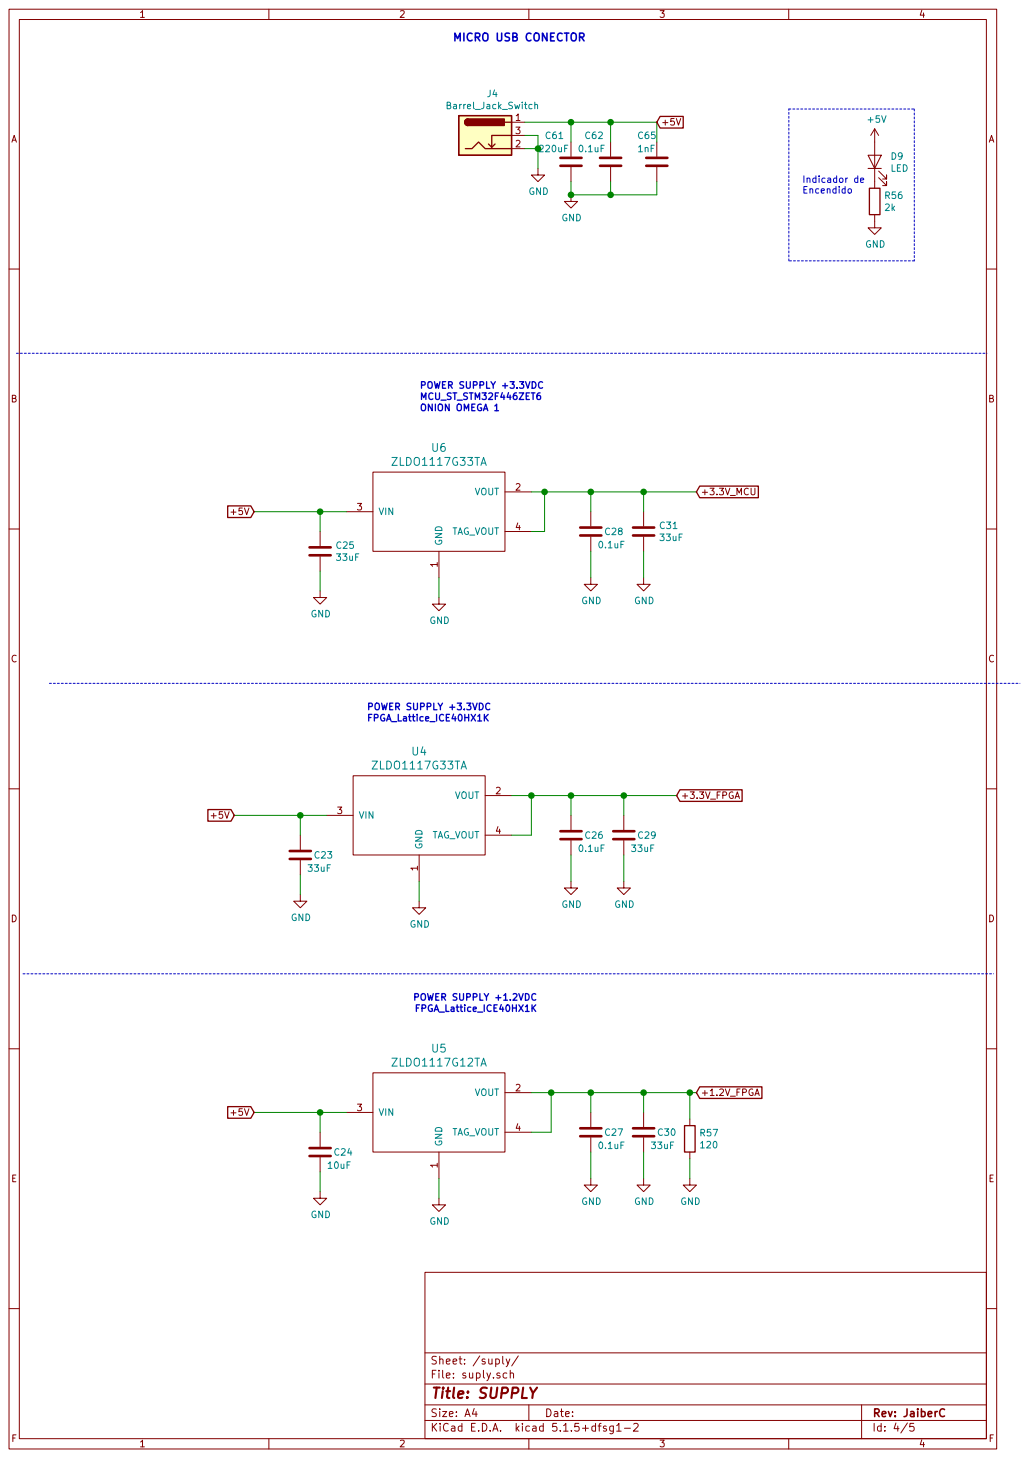
[picture p17: page 4]

POWER SUPPLY +3.3VDC MCU_ST_STM32F446ZET6 ONION OMEGA 1 POWER SUPPLY +3.3VDC

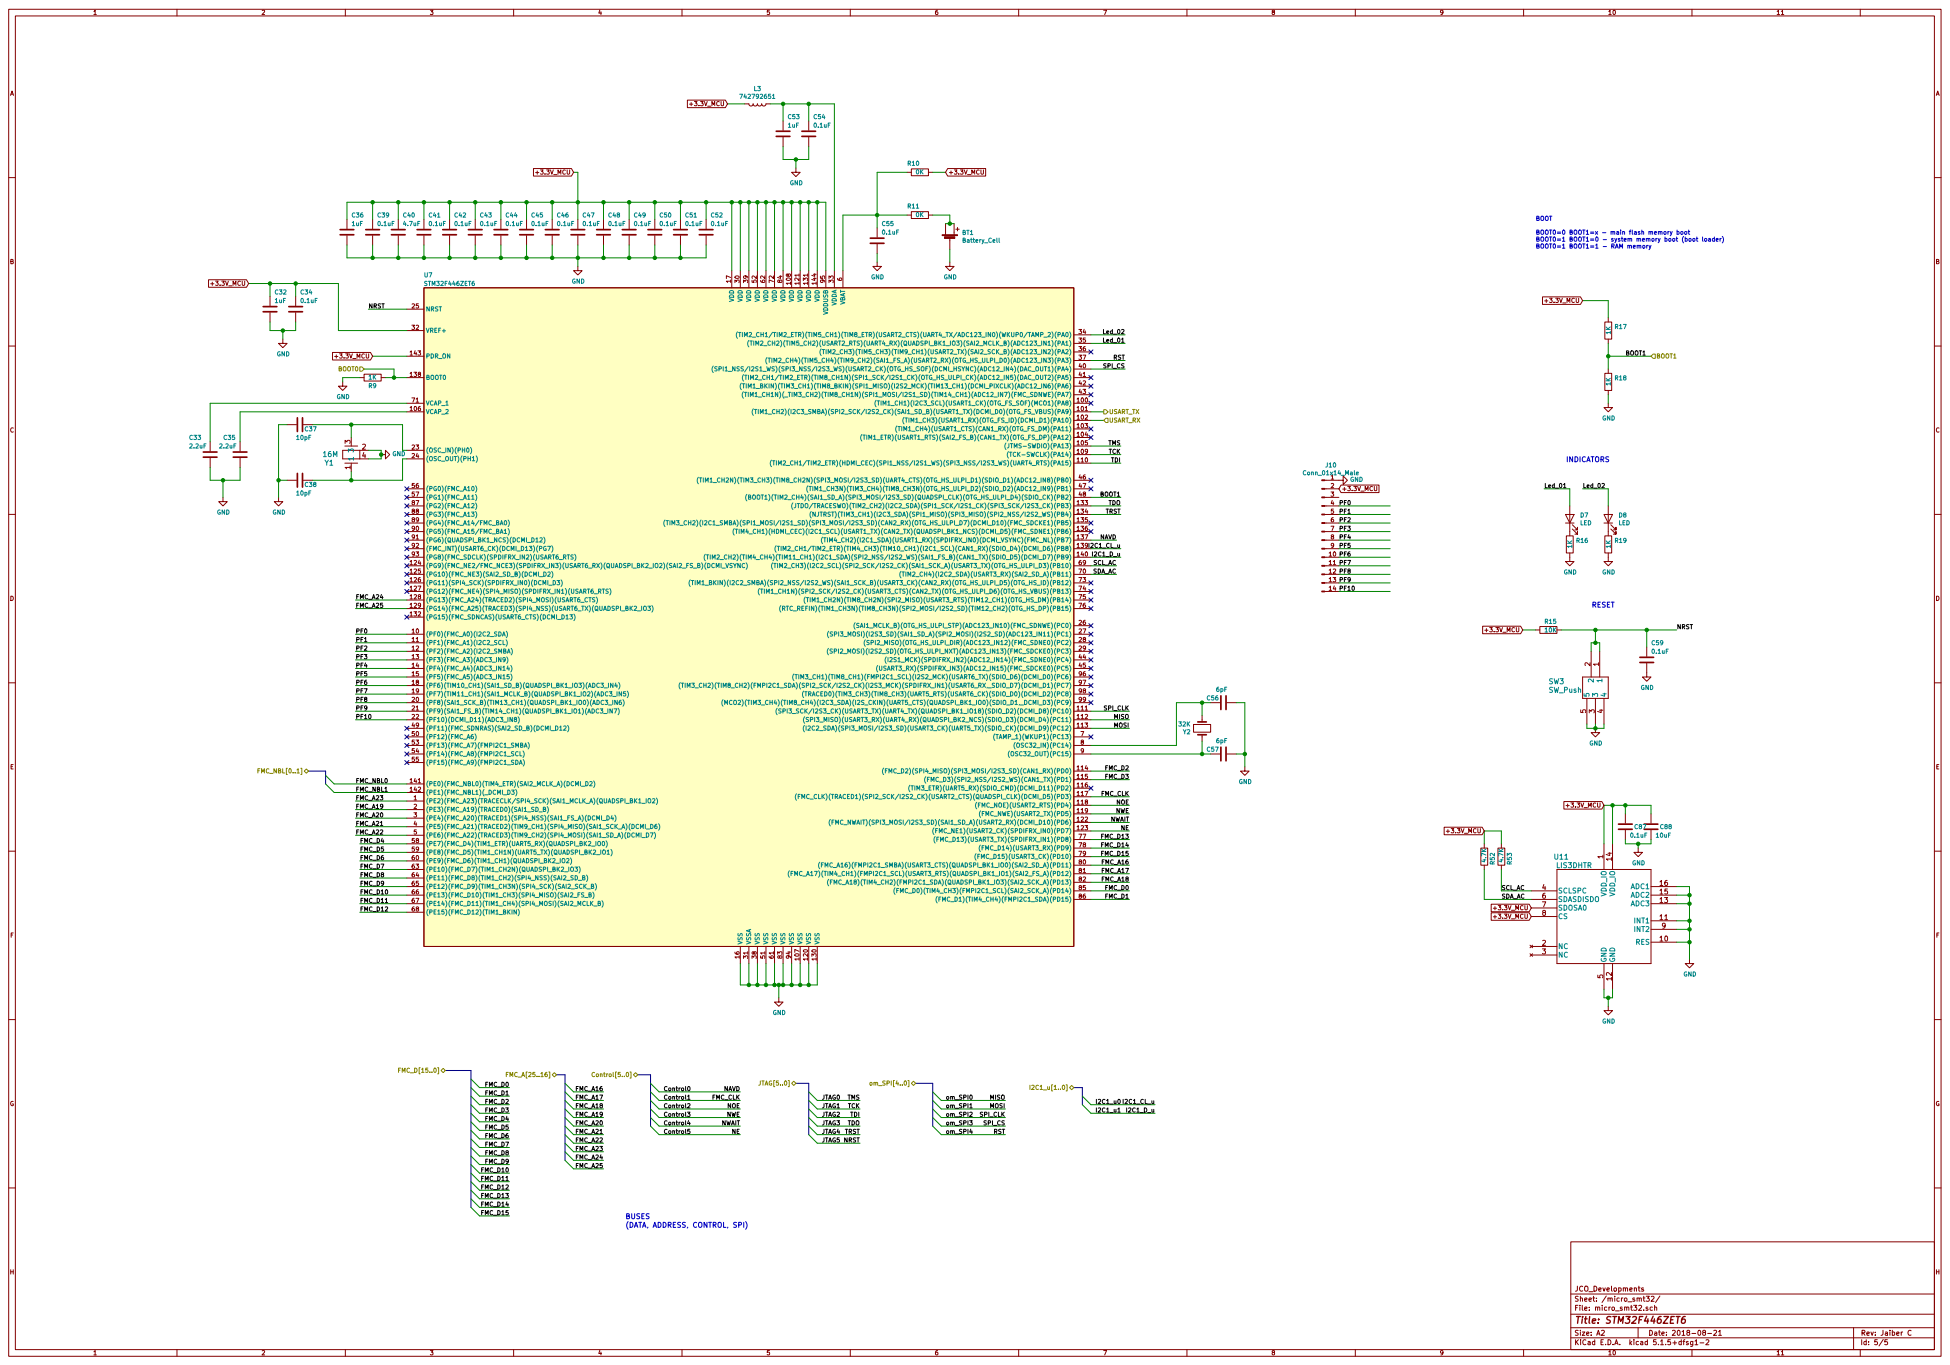
[picture p18: page 5]

BOOT BOOT0=0 BOOT1=x - main flash memory boot

BOOT0=1 BOOT1=0 - system memory boot (boot loader)
BOOT0=1 BOOT1=1 - RAM memory

BUSES
(DATA, ADDRESS, CONTROL, SPI)
