andref796/AICE/AICE/AICE.kicad_pcb

## KiCad design AICE/AICE.kicad_pcb (2020-06-23)

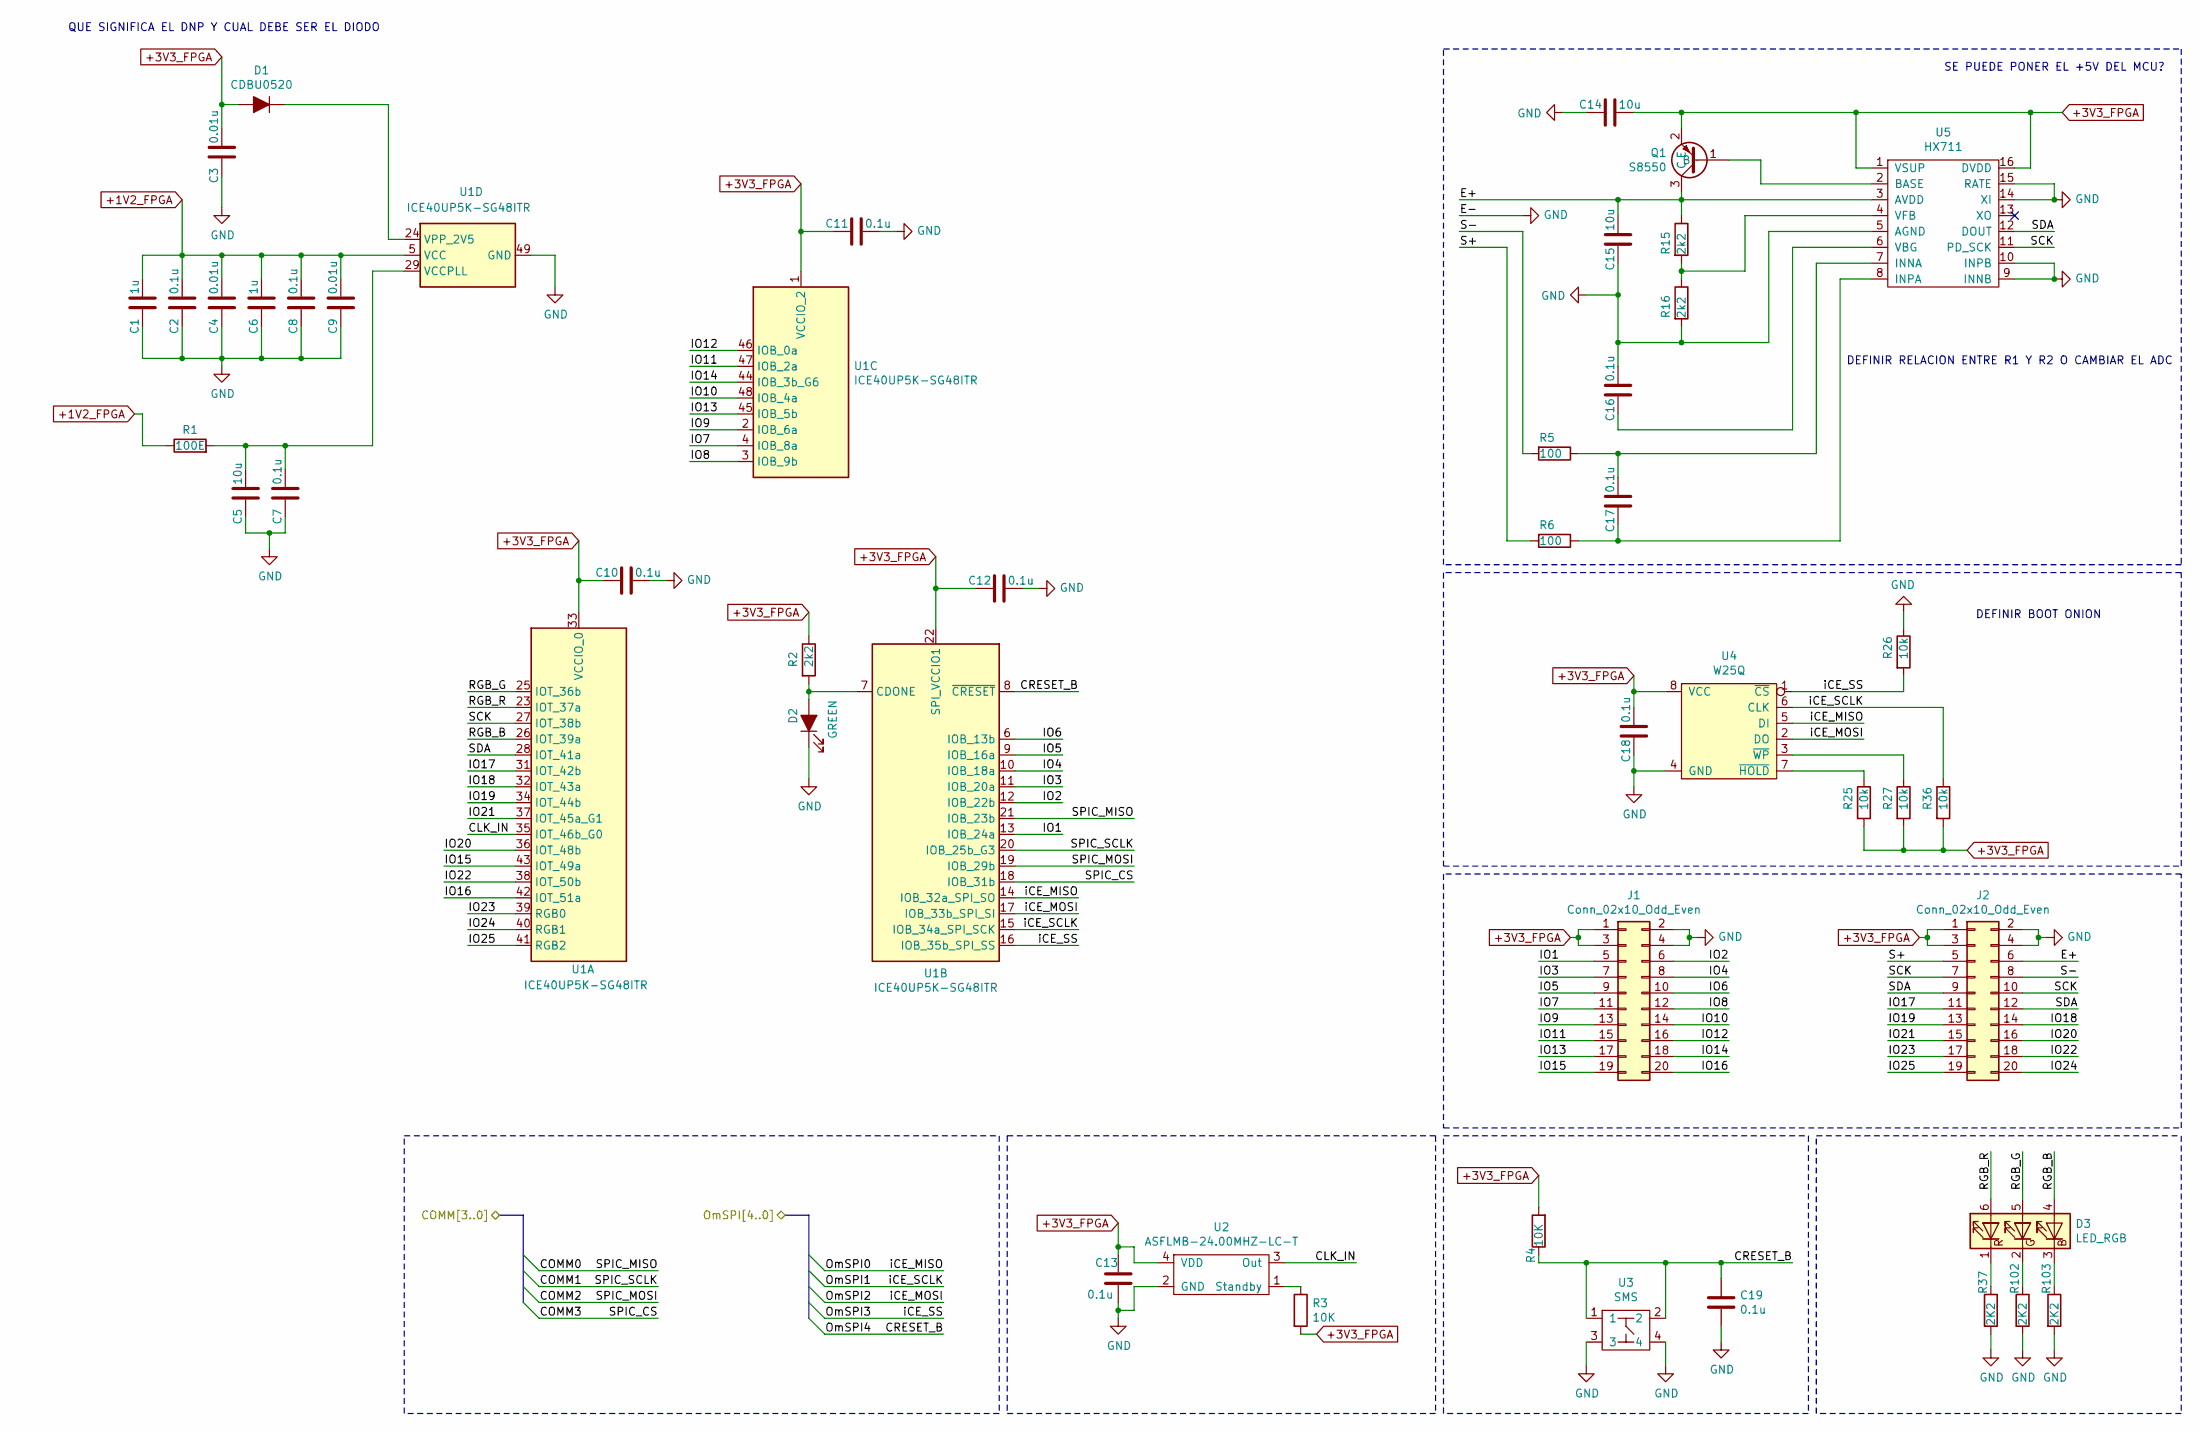
[picture p19: schematic iCE40.sch]

Parts:
C1, C6: 1u; C_0603_1608Metric
C2, C7, C8, C10, C11, C12, C13, C16, C17, C18, C19: 0.1u; C_0603_1608Metric
C3, C4, C9: 0.01u; C_0603_1608Metric
C5, C14, C15: 10u; C_0603_1608Metric
D1: CDBU0520; LED_0603_1608Metric
D2: GREEN; LED_0603_1608Metric
D3: LED_RGB; LED_RGB_Cree-PLCC-6_6x5mm_P2.1mm
J1, J2: Conn_02x10_Odd_Even; PinHeader_2x10_P2.54mm_Vertical
Q1: S8550; SOT-23
R1: 100E; R_0603_1608Metric
R2, R15, R16: 2k2; R_0603_1608Metric
R3, R4: 10K; R_0603_1608Metric
R5, R6: 100; R_0603_1608Metric
R25, R26, R27, R36: 10k; R_0603_1608Metric
R37, R102, R103: 2K2; R_0603_1608Metric
U1: ICE40UP5K-SG48ITR; QFN-48-1EP_7x7mm_P0.5mm_EP5.6x5.6mm
U2: ASFLMB-24.00MHZ-LC-T; ASFLMB
U3: SMS; SMS_BUTTON
U4: W25Q; SOIC-8_5.23x5.23mm_P1.27mm
U5: HX711; SOP-16_4.4x10.4mm_P1.27mm

Connections:
+1V2_FPGA: C1.1, C2.1, C4.1, C6.1, C8.1, C9.1, R1.1, U1.5 (VCC), U1.30 (VCC); also elsewhere on the board
+3V3_FPGA: C3.1, C10.2, C11.2, C12.2, C13.1, C14.1, C18.1, D1.2 (A), J1.1, J1.3, J2.1, J2.3, Q1.2 (E), R2.1, R3.2, R4.2, R25.2, R27.2, R36.2, U1.1 (VCCIO_2), U1.22 (SPI_VCCIO1), U1.33 (VCCIO_0), U2.4 (VDD), U4.8 (VCC), U5.1 (VSUP), U5.16 (DVDD); also elsewhere on the board
/iCE40/CLK_IN: U1.35 (IOT_46b_G0), U2.3 (Out)
/iCE40/COMM0: U1.21 (IOB_23b); also elsewhere on the board
/iCE40/COMM1: U1.20 (IOB_25b_G3); also elsewhere on the board
/iCE40/COMM2: U1.19 (IOB_29b); also elsewhere on the board
/iCE40/COMM3: U1.18 (IOB_31b); also elsewhere on the board
/iCE40/CRESET_B: C19.1, R4.1, U1.8 (~CRESET), U3.1, U3.2; also elsewhere on the board
/iCE40/E+: C15.1, J2.6, Q1.3 (C), R15.1, U5.3 (AVDD)
/iCE40/IO1: J1.5, U1.13 (IOB_24a)
/iCE40/IO2: J1.6, U1.12 (IOB_22b)
/iCE40/IO3: J1.7, U1.11 (IOB_20a)
/iCE40/IO4: J1.8, U1.10 (IOB_18a)
/iCE40/IO5: J1.9, U1.9 (IOB_16a)
/iCE40/IO6: J1.10, U1.6 (IOB_13b)
/iCE40/IO7: J1.11, U1.4 (IOB_8a)
/iCE40/IO8: J1.12, U1.3 (IOB_9b)
/iCE40/IO9: J1.13, U1.2 (IOB_6a)
/iCE40/IO10: J1.14, U1.48 (IOB_4a)
/iCE40/IO11: J1.15, U1.47 (IOB_2a)
/iCE40/IO12: J1.16, U1.46 (IOB_0a)
/iCE40/IO13: J1.17, U1.45 (IOB_5b)
/iCE40/IO14: J1.18, U1.44 (IOB_3b_G6)
/iCE40/IO15: J1.19, U1.43 (IOT_49a)
/iCE40/IO16: J1.20, U1.42 (IOT_51a)
/iCE40/IO17: J2.11, U1.31 (IOT_42b)
/iCE40/IO18: J2.14, U1.32 (IOT_43a)
/iCE40/IO19: J2.13, U1.34 (IOT_44b)
/iCE40/IO20: J2.16, U1.36 (IOT_48b)
/iCE40/IO21: J2.15, U1.37 (IOT_45a_G1)
/iCE40/IO22: J2.18, U1.38 (IOT_50b)
/iCE40/IO23: J2.17, U1.39 (RGB0)
/iCE40/IO24: J2.20, U1.40 (RGB1)
/iCE40/IO25: J2.19, U1.41 (RGB2)
/iCE40/OmSPI0: U1.14 (IOB_32a_SPI_SO), U4.5 (DI); also elsewhere on the board
/iCE40/OmSPI1: R36.1, U1.15 (IOB_34a_SPI_SCK), U4.6 (CLK); also elsewhere on the board
/iCE40/OmSPI2: U1.17 (IOB_33b_SPI_SI), U4.2 (DO); also elsewhere on the board
/iCE40/OmSPI3: R26.2, U1.16 (IOB_35b_SPI_SS), U4.1 (~CS~); also elsewhere on the board
/iCE40/RGB_B: D3.4 (BA), U1.26 (IOT_39a)
/iCE40/RGB_G: D3.5 (GA), U1.25 (IOT_36b)
/iCE40/RGB_R: D3.6 (RA), U1.23 (IOT_37a)
/iCE40/S+: J2.5, R6.2
/iCE40/S-: J2.8, R5.2
/iCE40/SCK: J2.7, J2.10, U1.27 (IOT_38b), U5.11 (PD_SCK)
/iCE40/SDA: J2.9, J2.12, U1.28 (IOT_41a), U5.12 (DOUT)
GND: C1.2, C2.2, C3.2, C4.2, C5.2, C6.2, C7.2, C8.2, C9.2, C10.1, C11.1, C12.1, C13.2, C14.2, C15.2, C16.1, C18.2, C19.2, D2.1 (K), J1.2, J1.4, J2.2, J2.4, R16.2, R26.1, R37.2, R102.2, R103.2, U1.49 (GND), U2.2 (GND), U3.3, U3.4, U4.4 (GND), U5.5 (AGND), U5.9 (INNB), U5.10 (INPB), U5.14 (XI), U5.15 (RATE); also elsewhere on the board
unnamed: C5.1, C7.1, R1.2, U1.29 (VCCPLL)
unnamed: C16.2, U5.6 (VBG)
unnamed: C17.1, R5.1, U5.7 (INNA)
unnamed: C17.2, R6.1, U5.8 (INPA)
unnamed: D1.1 (K), U1.24 (VPP_2V5)
unnamed: D2.2 (A), R2.2, U1.7 (CDONE)
unnamed: D3.1 (RK), R37.1
unnamed: D3.2 (GK), R102.1
unnamed: D3.3 (BK), R103.1
unnamed: Q1.1 (B), U5.2 (BASE)
unnamed: R3.1, U2.1 (Standby)
unnamed: R15.2, R16.1, U5.4 (VFB)
unnamed: R25.1, U4.7 (~HOLD)
unnamed: R27.1, U4.3 (~WP)

Notes on the sheet:
SE PUEDE PONER EL +5V DEL MCU?
QUE SIGNIFICA EL DNP Y CUAL DEBE SER EL DIODO
DEFINIR BOOT ONION
DEFINIR RELACION ENTRE R1 Y R2 O CAMBIAR EL ADC

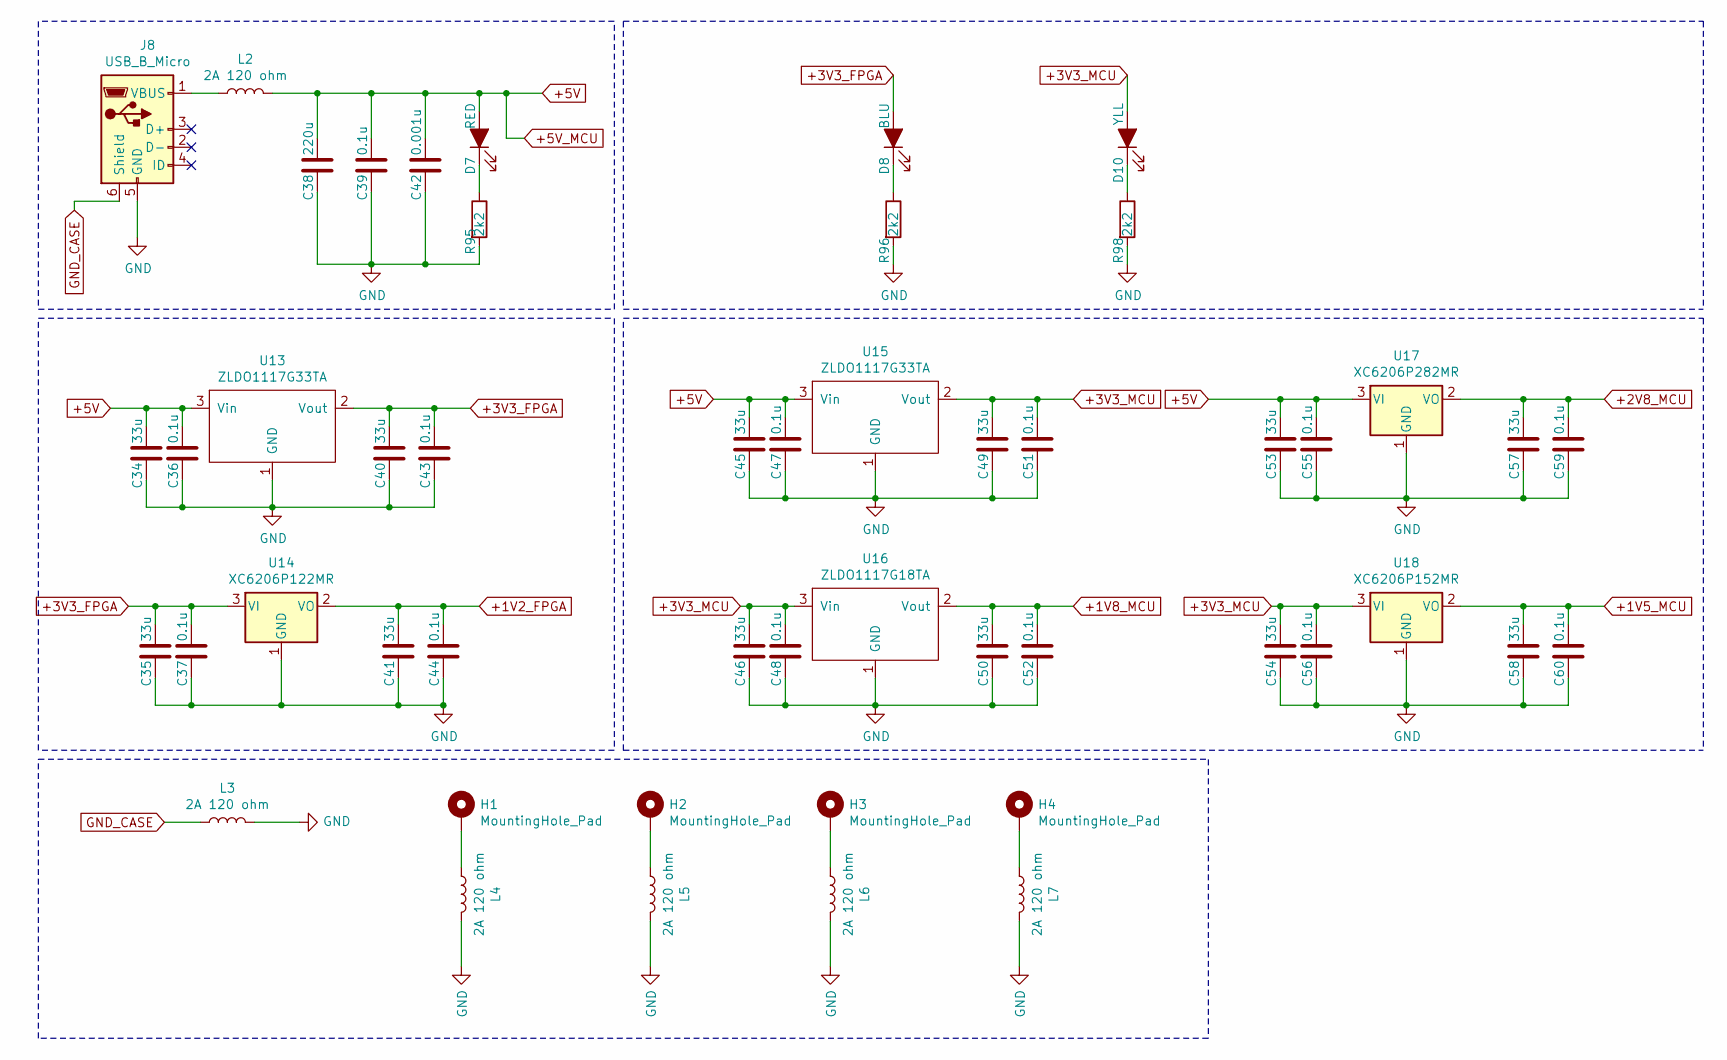
[picture p20: schematic power.sch]

Parts:
C34, C35, C40, C41, C45, C46, C49, C50, C53, C54, C57, C58: 33u; C_0805_2012Metric
C36, C37, C39, C43, C44, C47, C48, C51, C52, C55, C56, C59, C60: 0.1u; C_0603_1608Metric
C38: 220u; C_1206_3216Metric
C42: 0.001u; C_0603_1608Metric
D7: RED; LED_0603_1608Metric
D8: BLU; LED_0603_1608Metric
D10: YLL; LED_0603_1608Metric
H1, H2, H3, H4: MountingHole_Pad; MountingHole_2.5mm_Pad
J8: USB_B_Micro; USB_Micro-B_Molex_47346-0001
L2, L3, L4, L5, L6, L7: 2A 120 ohm; L_0805_2012Metric
R95, R96, R98: 2k2; R_0603_1608Metric
U13, U15: ZLDO1117G33TA; SOT-223
U14: XC6206P122MR; SOT-23
U16: ZLDO1117G18TA; SOT-223
U17: XC6206P282MR; SOT-23
U18: XC6206P152MR; SOT-23

Connections:
+1V2_FPGA: C41.1, C44.1, U14.2 (VO); also elsewhere on the board
+1V5_MCU: C58.1, C60.1, U18.2 (VO); also elsewhere on the board
+1V8_MCU: C50.1, C52.1, U16.2 (Vout); also elsewhere on the board
+2V8_MCU: C57.1, C59.1, U17.2 (VO); also elsewhere on the board
+3V3_FPGA: C35.1, C37.1, C40.1, C43.1, D8.2 (A), U13.2 (Vout), U14.3 (VI); also elsewhere on the board
+3V3_MCU: C46.1, C48.1, C49.1, C51.1, C54.1, C56.1, D10.2 (A), U15.2 (Vout), U16.3 (Vin), U18.3 (VI); also elsewhere on the board
+5V: C34.1, C36.1, C38.1, C39.1, C42.1, C45.1, C47.1, C53.1, C55.1, D7.2 (A), L2.2, U13.3 (Vin), U15.3 (Vin), U17.3 (VI); also elsewhere on the board
GND: C34.2, C35.2, C36.2, C37.2, C38.2, C39.2, C40.2, C41.2, C42.2, C43.2, C44.2, C45.2, C46.2, C47.2, C48.2, C49.2, C50.2, C51.2, C52.2, C53.2, C54.2, C55.2, C56.2, C57.2, C58.2, C59.2, C60.2, J8.5 (GND), L3.2, L4.2, L5.2, L6.2, L7.2, R95.2, R96.2, R98.2, U13.1 (GND), U14.1 (GND), U15.1 (GND), U16.1 (GND), U17.1 (GND), U18.1 (GND); also elsewhere on the board
GND_CASE: J8.6 (Shield), L3.1
unnamed: D7.1 (K), R95.1
unnamed: D8.1 (K), R96.1
unnamed: D10.1 (K), R98.1
unnamed: H1.1, L4.1
unnamed: H2.1, L5.1
unnamed: H3.1, L6.1
unnamed: H4.1, L7.1
unnamed: J8.1 (VBUS), L2.1

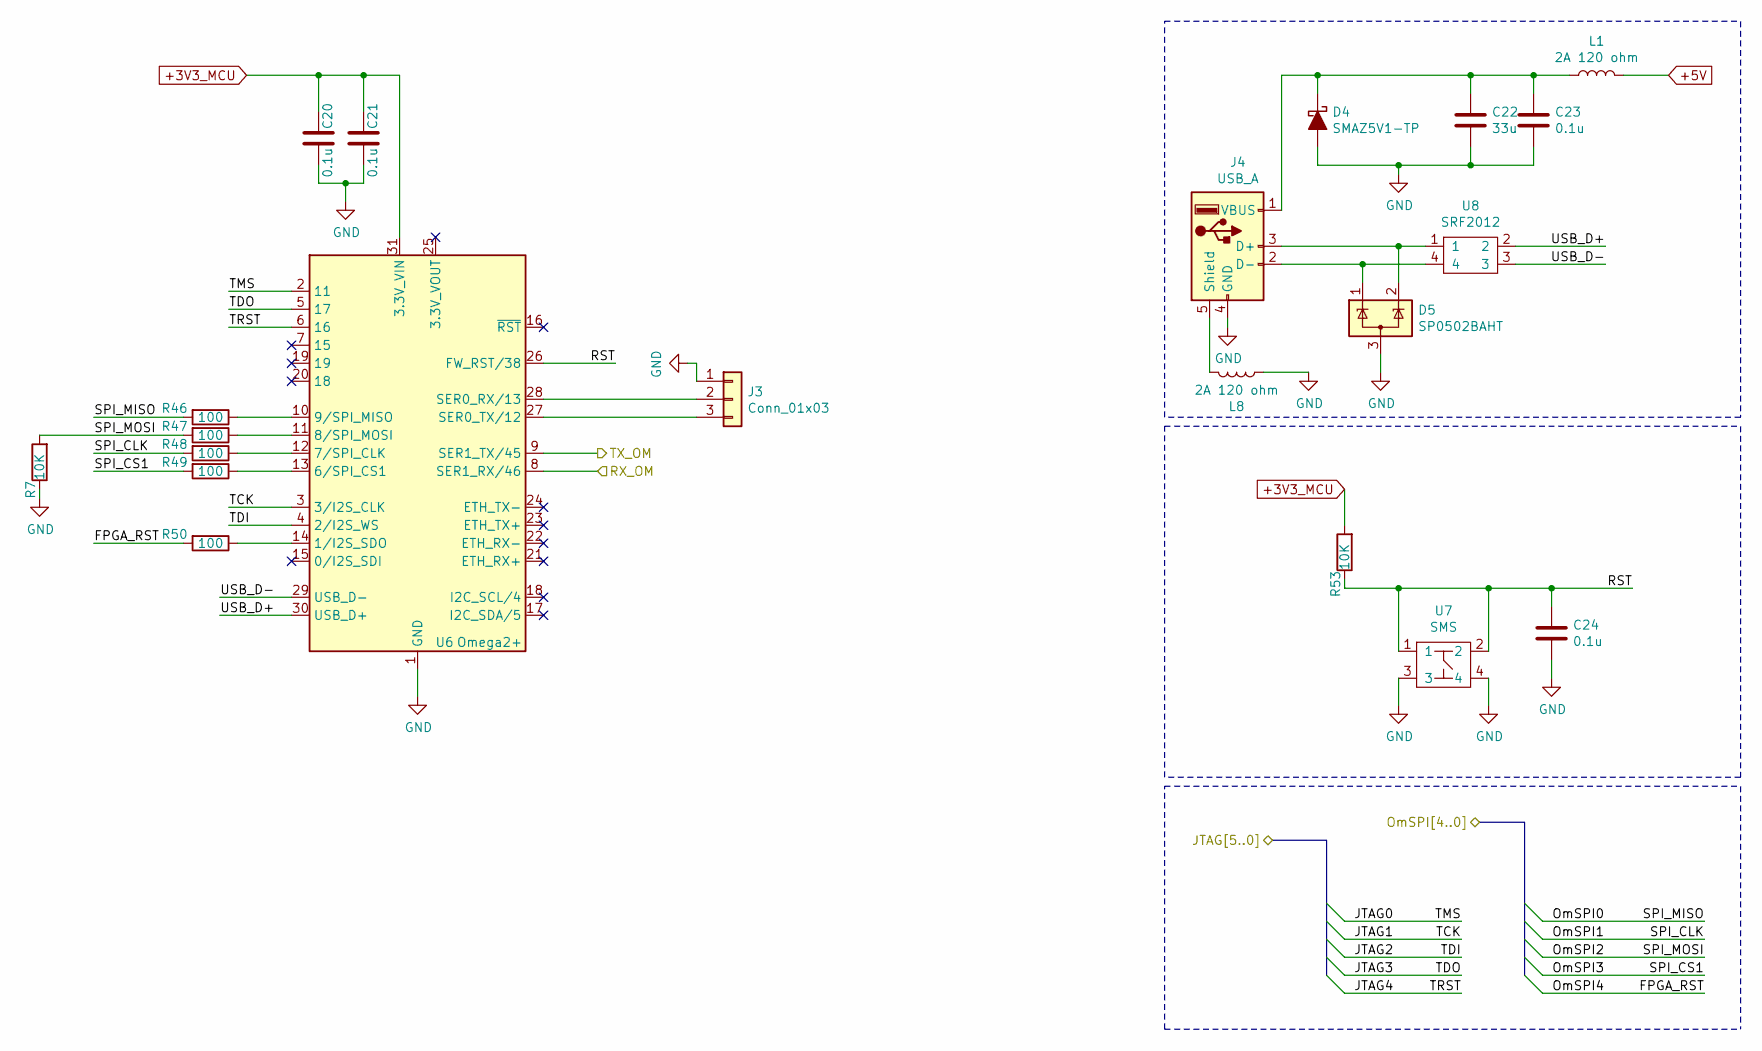
[picture p21: schematic omega.sch]

Parts:
C20, C21, C23, C24: 0.1u; C_0603_1608Metric
C22: 33u; CP_Radial_D5.0mm_P2.00mm
D4: SMAZ5V1-TP; D_SMA
D5: SP0502BAHT; SOT-23
J3: Conn_01x03; PinHeader_1x03_P2.54mm_Vertical
J4: USB_A; USB_A_Stewart_SS-52100-001_Horizontal
L1, L8: 2A 120 ohm; L_0805_2012Metric
R7, R53: 10K; R_0603_1608Metric
R46, R47, R48, R49, R50: 100; R_0603_1608Metric
U6: Omega2+; Onion_Omega2+
U7: SMS; SMS_BUTTON
U8: SRF2012

Connections:
+3V3_MCU: C20.2, C21.2, R53.2, U6.31 (3.3V_VIN); also elsewhere on the board
+5V: L1.2; also elsewhere on the board
/iCE40/CRESET_B: R50.2; also elsewhere on the board
/iCE40/OmSPI0: R46.2; also elsewhere on the board
/iCE40/OmSPI1: R48.2; also elsewhere on the board
/iCE40/OmSPI2: R7.2, R47.2; also elsewhere on the board
/iCE40/OmSPI3: R49.2; also elsewhere on the board
/omega/JTAG0: U6.2 (11); also elsewhere on the board
/omega/JTAG1: U6.3 (3/I2S_CLK); also elsewhere on the board
/omega/JTAG2: U6.4 (2/I2S_WS); also elsewhere on the board
/omega/JTAG3: U6.5 (17); also elsewhere on the board
/omega/JTAG4: U6.6 (16); also elsewhere on the board
/omega/RST: C24.1, R53.1, U6.26 (FW_RST/38), U7.1, U7.2
/omega/RX_OM: U6.8 (SER1_RX/46); also elsewhere on the board
/omega/USB_D+: U6.30 (USB_D+), U8.2
/omega/USB_D-: U6.29 (USB_D-), U8.3
/sipeedm1w/RX_M1: U6.9 (SER1_TX/45); also elsewhere on the board
GND: C20.1, C21.1, C22.2, C23.2, C24.2, D4.2 (A), D5.3 (A), J3.1, J4.4 (GND), L8.1, R7.1, U6.1 (GND), U6.32 (GND), U7.3, U7.4; also elsewhere on the board
unnamed: C22.1, C23.1, D4.1 (K), J4.1 (VBUS), L1.1
unnamed: D5.1 (K), J4.2 (D-), U8.4
unnamed: D5.2 (K), J4.3 (D+), U8.1
unnamed: J3.2, U6.28 (SER0_RX/13)
unnamed: J3.3, U6.27 (SER0_TX/12)
unnamed: J4.5 (Shield), L8.2
unnamed: R46.1, U6.10 (9/SPI_MISO)
unnamed: R47.1, U6.11 (8/SPI_MOSI)
unnamed: R48.1, U6.12 (7/SPI_CLK)
unnamed: R49.1, U6.13 (6/SPI_CS1)
unnamed: R50.1, U6.14 (1/I2S_SDO)

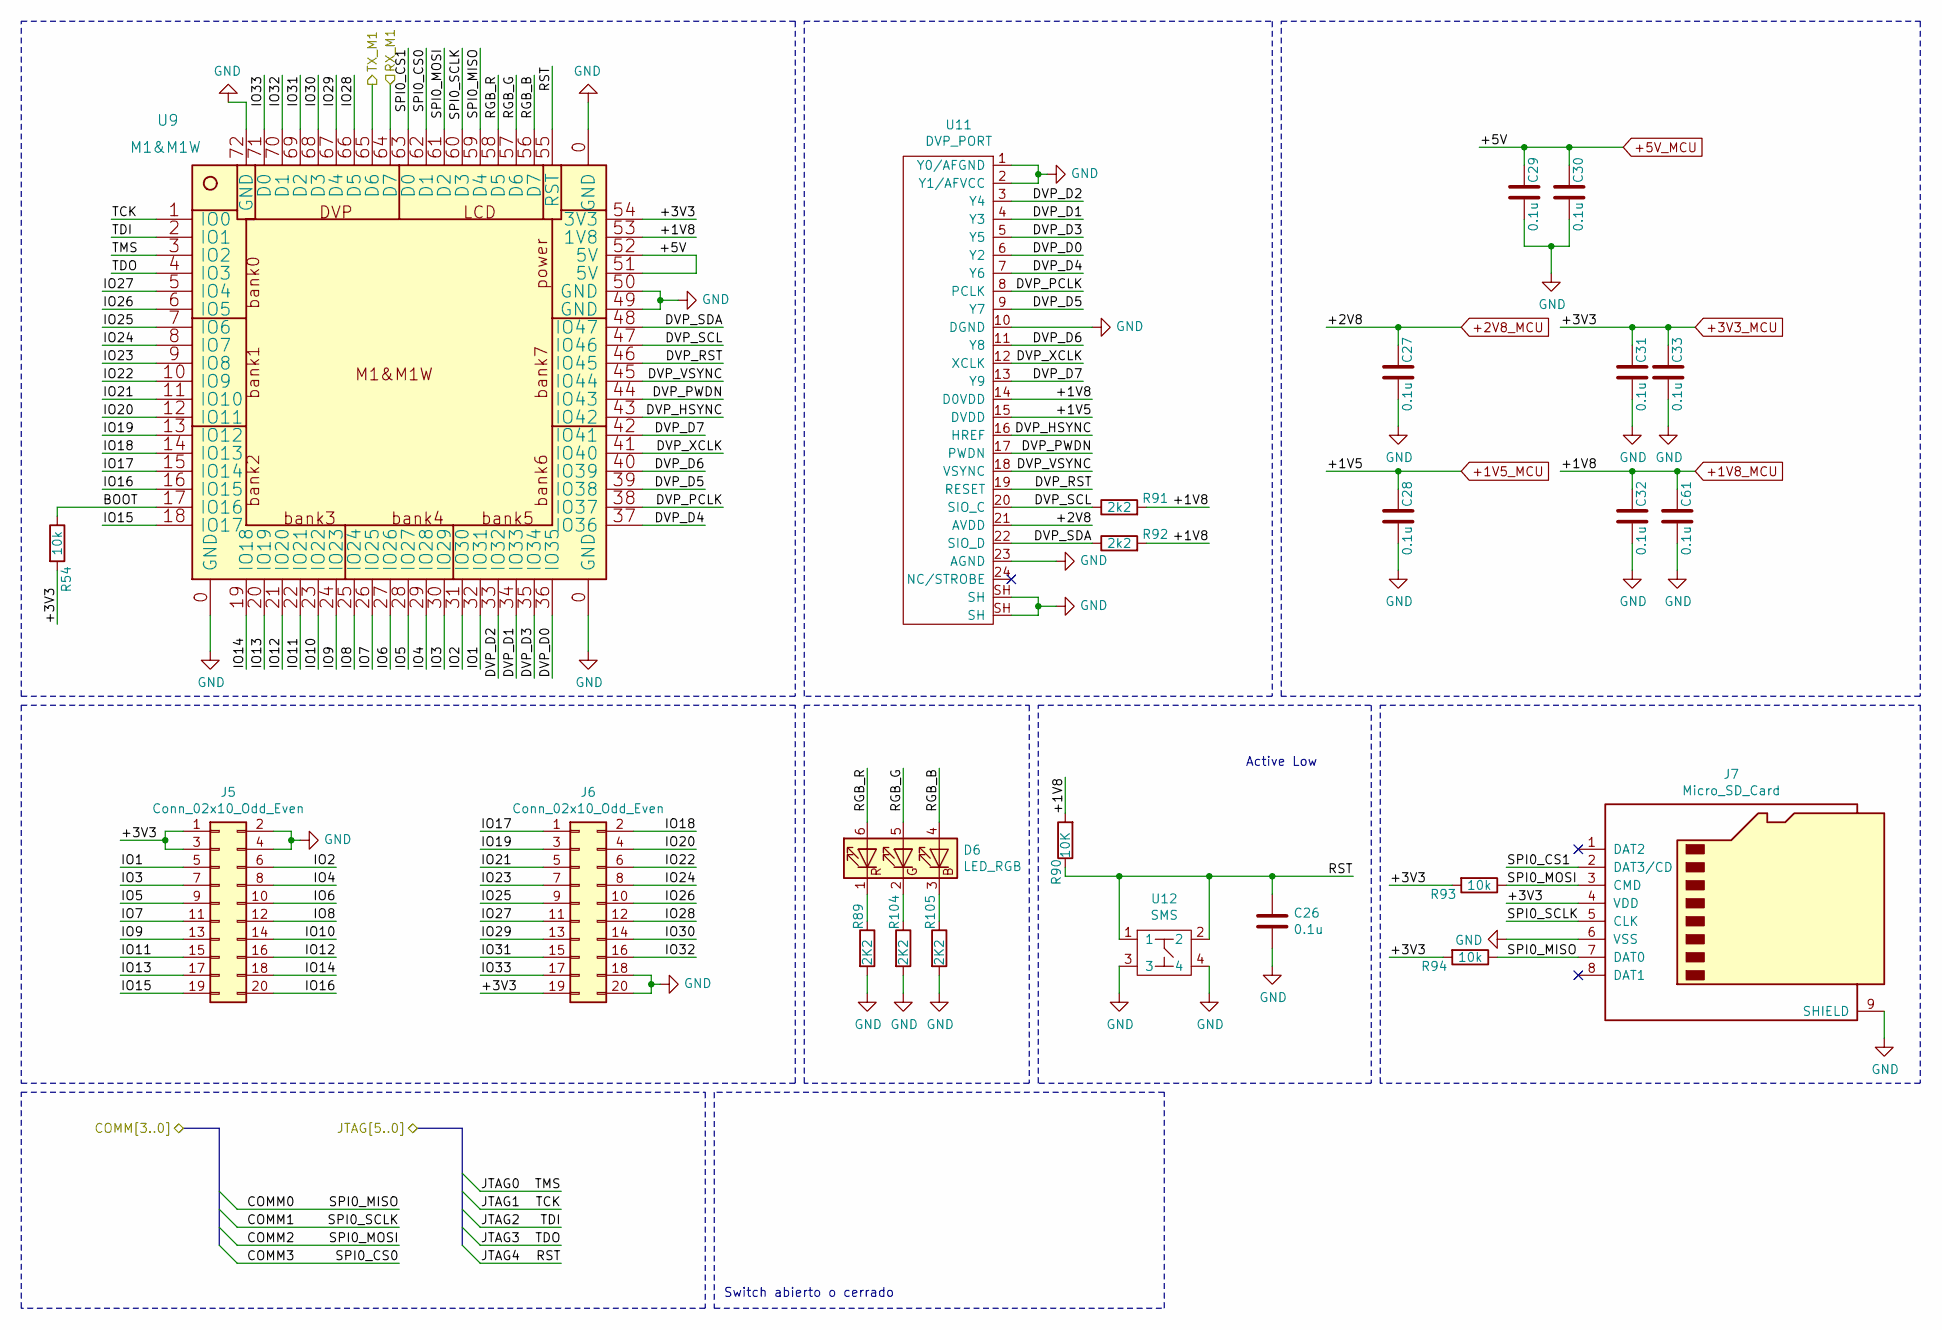
[picture p22: schematic sipeedm1w.sch]

Parts:
C26, C27, C28, C29, C30, C31, C32, C33, C61: 0.1u; C_0603_1608Metric
D6: LED_RGB; LED_RGB_Cree-PLCC-6_6x5mm_P2.1mm
J5, J6: Conn_02x10_Odd_Even; PinHeader_2x10_P2.54mm_Vertical
J7: Micro_SD_Card; microSD_HC_Wuerth_693072010801
R54, R93, R94: 10k; R_0603_1608Metric
R89, R104, R105: 2K2; R_0603_1608Metric
R90: 10K; R_0603_1608Metric
R91, R92: 2k2; R_0603_1608Metric
U9: M1&M1W; QFN-72_25.4x25.4_Pitch1.27mm
U11: DVP_PORT; Molex_502231-2400_1x24-1SH_P0.5mm_Vertical
U12: SMS; SMS_BUTTON

Connections:
+1V5_MCU: C28.2, U11.15 (DVDD); also elsewhere on the board
+1V8_MCU: C32.2, C61.2, R90.2, R91.2, R92.2, U9.53 (1V8), U11.14 (D0VDD); also elsewhere on the board
+2V8_MCU: C27.2, U11.21 (AVDD); also elsewhere on the board
+3V3_MCU: C31.2, C33.2, J5.1, J5.3, J6.19, J7.4 (VDD), R54.2, R93.2, R94.2, U9.54 (3V3); also elsewhere on the board
+5V: C29.2, C30.2, U9.51 (5V), U9.52 (5V); also elsewhere on the board
/iCE40/COMM0: J7.7 (DAT0), R94.1, U9.59 (D4); also elsewhere on the board
/iCE40/COMM1: J7.5 (CLK), U9.60 (D3); also elsewhere on the board
/iCE40/COMM2: J7.3 (CMD), R93.1, U9.61 (D2); also elsewhere on the board
/iCE40/COMM3: U9.62 (D1); also elsewhere on the board
/omega/JTAG0: U9.3 (IO2); also elsewhere on the board
/omega/JTAG1: U9.1 (IO0); also elsewhere on the board
/omega/JTAG2: U9.2 (IO1); also elsewhere on the board
/omega/JTAG3: U9.4 (IO3); also elsewhere on the board
/omega/JTAG4: C26.1, R90.1, U9.55 (RST), U12.1, U12.2; also elsewhere on the board
/omega/RX_OM: U9.65 (D6); also elsewhere on the board
/sipeedm1w/BOOT: R54.1, U9.17 (IO16)
/sipeedm1w/DVP_D0: U9.36 (IO35), U11.6 (Y2)
/sipeedm1w/DVP_D1: U9.34 (IO33), U11.4 (Y3)
/sipeedm1w/DVP_D2: U9.33 (IO32), U11.3 (Y4)
/sipeedm1w/DVP_D3: U9.35 (IO34), U11.5 (Y5)
/sipeedm1w/DVP_D4: U9.37 (IO36), U11.7 (Y6)
/sipeedm1w/DVP_D5: U9.39 (IO38), U11.9 (Y7)
/sipeedm1w/DVP_D6: U9.40 (IO39), U11.11 (Y8)
/sipeedm1w/DVP_D7: U9.42 (IO41), U11.13 (Y9)
/sipeedm1w/DVP_HSYNC: U9.43 (IO42), U11.16 (HREF)
/sipeedm1w/DVP_PCLK: U9.38 (IO37), U11.8 (PCLK)
/sipeedm1w/DVP_PWDN: U9.44 (IO43), U11.17 (PWDN)
/sipeedm1w/DVP_RST: U9.46 (IO45), U11.19 (RESET)
/sipeedm1w/DVP_SCL: R91.1, U9.47 (IO46), U11.20 (SIO_C)
/sipeedm1w/DVP_SDA: R92.1, U9.48 (IO47), U11.22 (SIO_D)
/sipeedm1w/DVP_VSYNC: U9.45 (IO44), U11.18 (VSYNC)
/sipeedm1w/DVP_XCLK: U9.41 (IO40), U11.12 (XCLK)
/sipeedm1w/IO1: J5.5, U9.32 (IO31)
/sipeedm1w/IO2: J5.6, U9.31 (IO30)
/sipeedm1w/IO3: J5.7, U9.30 (IO29)
/sipeedm1w/IO4: J5.8, U9.29 (IO28)
/sipeedm1w/IO5: J5.9, U9.28 (IO27)
/sipeedm1w/IO6: J5.10, U9.27 (IO26)
/sipeedm1w/IO7: J5.11, U9.26 (IO25)
/sipeedm1w/IO8: J5.12, U9.25 (IO24)
/sipeedm1w/IO9: J5.13, U9.24 (IO23)
/sipeedm1w/IO10: J5.14, U9.23 (IO22)
/sipeedm1w/IO11: J5.15, U9.22 (IO21)
/sipeedm1w/IO12: J5.16, U9.21 (IO20)
/sipeedm1w/IO13: J5.17, U9.20 (IO19)
/sipeedm1w/IO14: J5.18, U9.19 (IO18)
/sipeedm1w/IO15: J5.19, U9.18 (IO17)
/sipeedm1w/IO16: J5.20, U9.16 (IO15)
/sipeedm1w/IO17: J6.1, U9.15 (IO14)
/sipeedm1w/IO18: J6.2, U9.14 (IO13)
/sipeedm1w/IO19: J6.3, U9.13 (IO12)
/sipeedm1w/IO20: J6.4, U9.12 (IO11)
/sipeedm1w/IO21: J6.5, U9.11 (IO10)
/sipeedm1w/IO22: J6.6, U9.10 (IO9)
/sipeedm1w/IO23: J6.7, U9.9 (IO8)
/sipeedm1w/IO24: J6.8, U9.8 (IO7)
/sipeedm1w/IO25: J6.9, U9.7 (IO6)
/sipeedm1w/IO26: J6.10, U9.6 (IO5)
/sipeedm1w/IO27: J6.11, U9.5 (IO4)
/sipeedm1w/IO28: J6.12, U9.66 (D5)
/sipeedm1w/IO29: J6.13, U9.67 (D4)
/sipeedm1w/IO30: J6.14, U9.68 (D3)
/sipeedm1w/IO31: J6.15, U9.69 (D2)
/sipeedm1w/IO32: J6.16, U9.70 (D1)
/sipeedm1w/IO33: J6.17, U9.71 (D0)
/sipeedm1w/RGB_B: D6.4 (BA), U9.56 (D7)
/sipeedm1w/RGB_G: D6.5 (GA), U9.57 (D6)
/sipeedm1w/RGB_R: D6.6 (RA), U9.58 (D5)
/sipeedm1w/RX_M1: U9.64 (D7); also elsewhere on the board
/sipeedm1w/SPI0_CS1: J7.2 (DAT3/CD), U9.63 (D0)
GND: C26.2, C27.1, C28.1, C29.1, C30.1, C31.1, C32.1, C33.1, C61.1, J5.2, J5.4, J6.18, J6.20, J7.6 (VSS), J7.9 (SHIELD), R89.2, R104.2, R105.2, U9.0 (GND), U9.49 (GND), U9.50 (GND), U9.72 (GND), U11.1 (Y0/AFGND), U11.2 (Y1/AFVCC), U11.10 (DGND), U11.23 (AGND), U11.SH, U12.3, U12.4; also elsewhere on the board
unnamed: D6.1 (RK), R89.1
unnamed: D6.2 (GK), R104.1
unnamed: D6.3 (BK), R105.1

Notes on the sheet:
Switch abierto o cerrado
Active Low

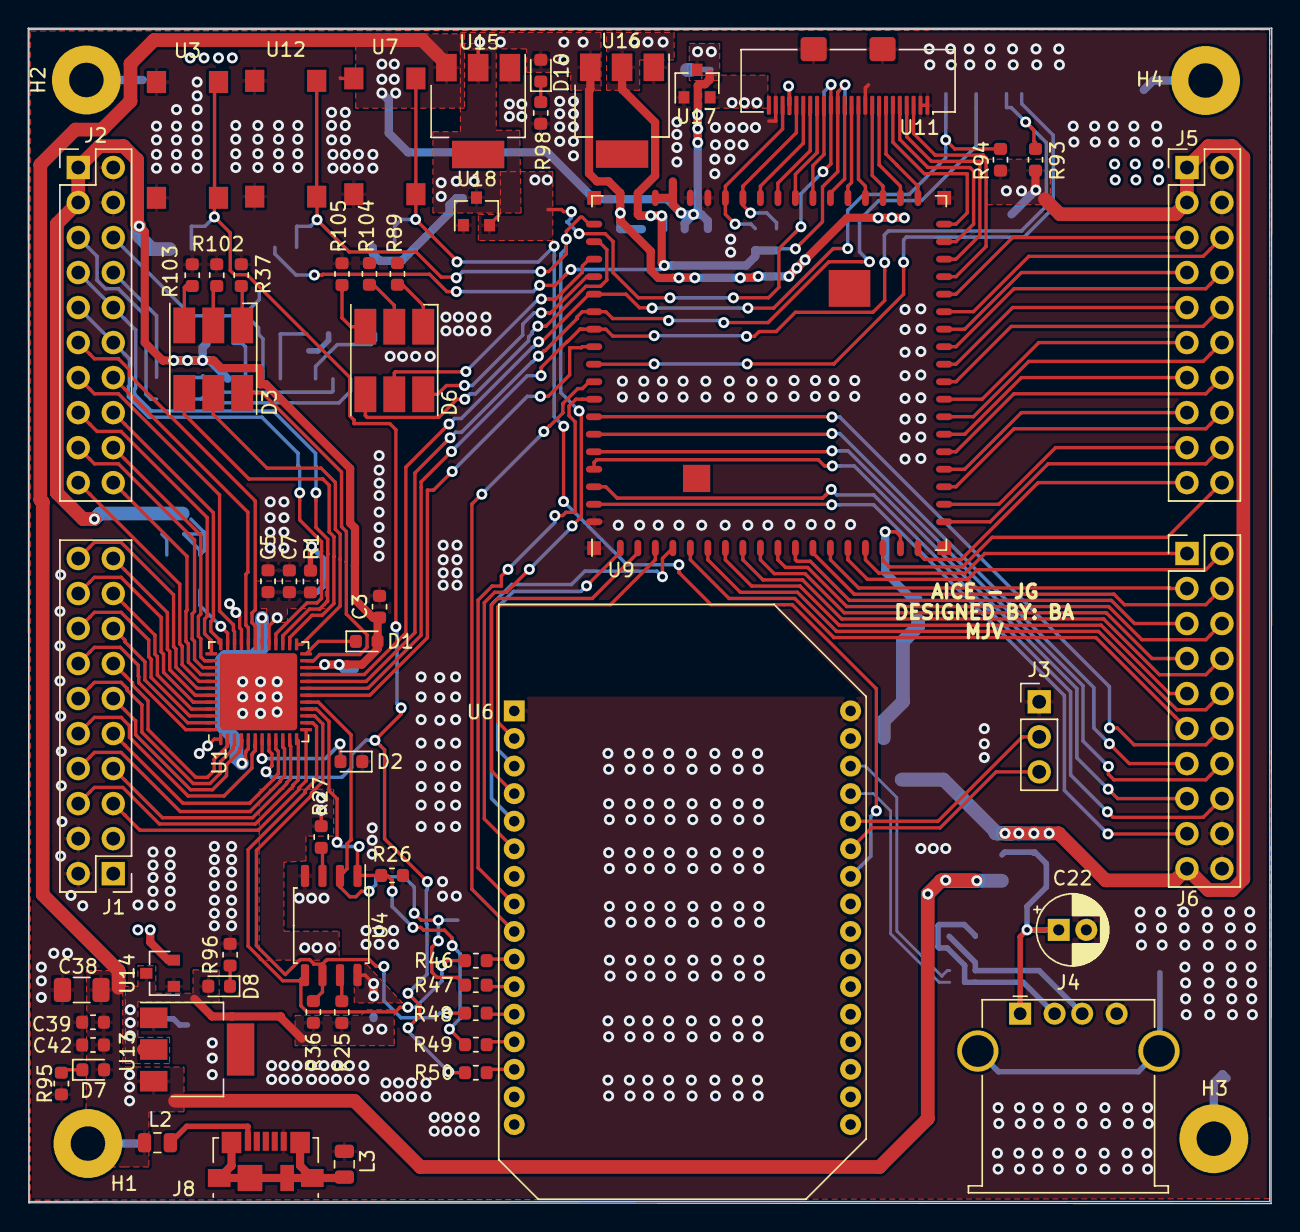
[picture p23: board AICE.kicad_pcb from above]

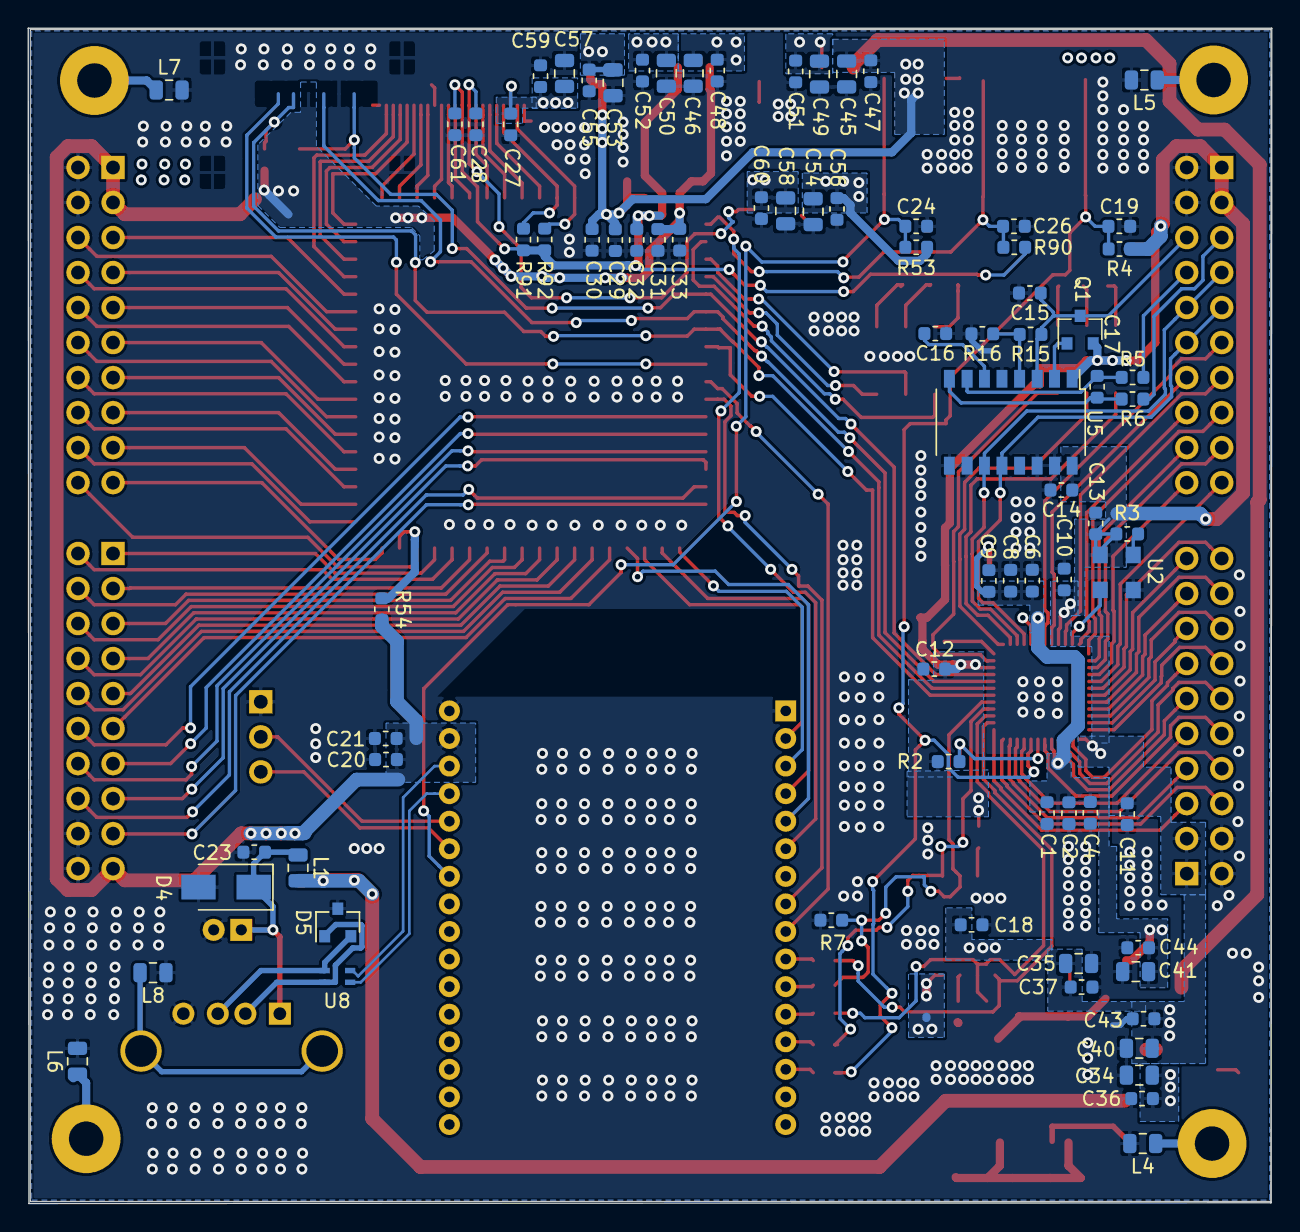
[picture p24: board AICE.kicad_pcb from below]

Board: 2 copper layers, 90.2 x 85.2 mm, 140 parts (78 on the bottom side), 151 nets.
